SukuWc/FR4-Quad/Render/SensorMix/SensorMix_TOP.png

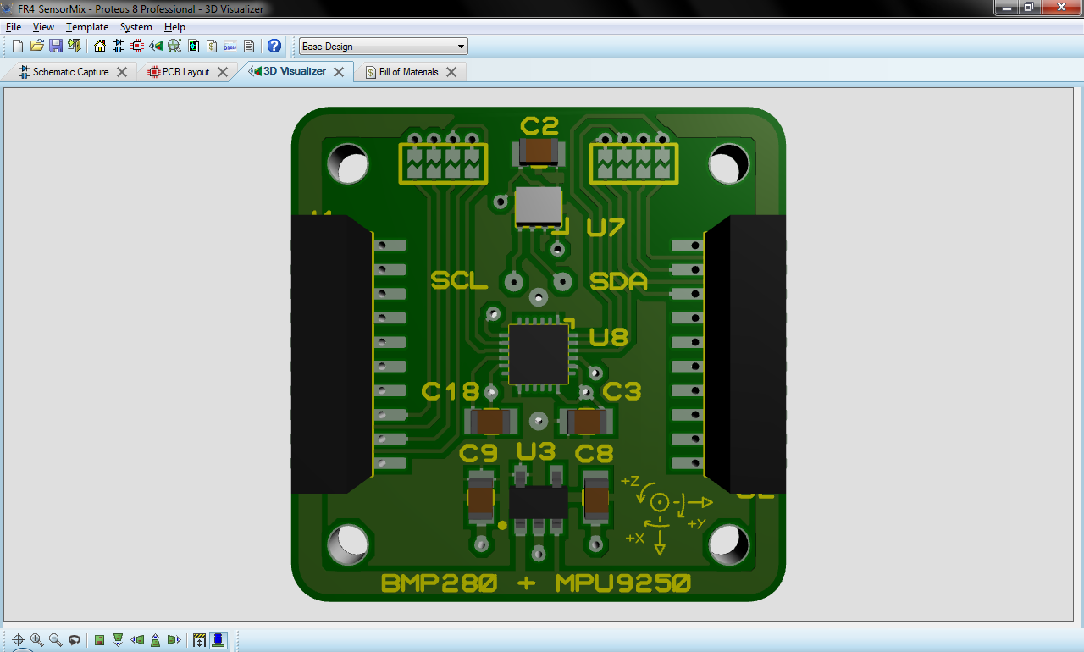
Render/SensorMix/SensorMix_TOP.png
