SukuWc/FR4-Quad/gerber/TOP_COPPER.png

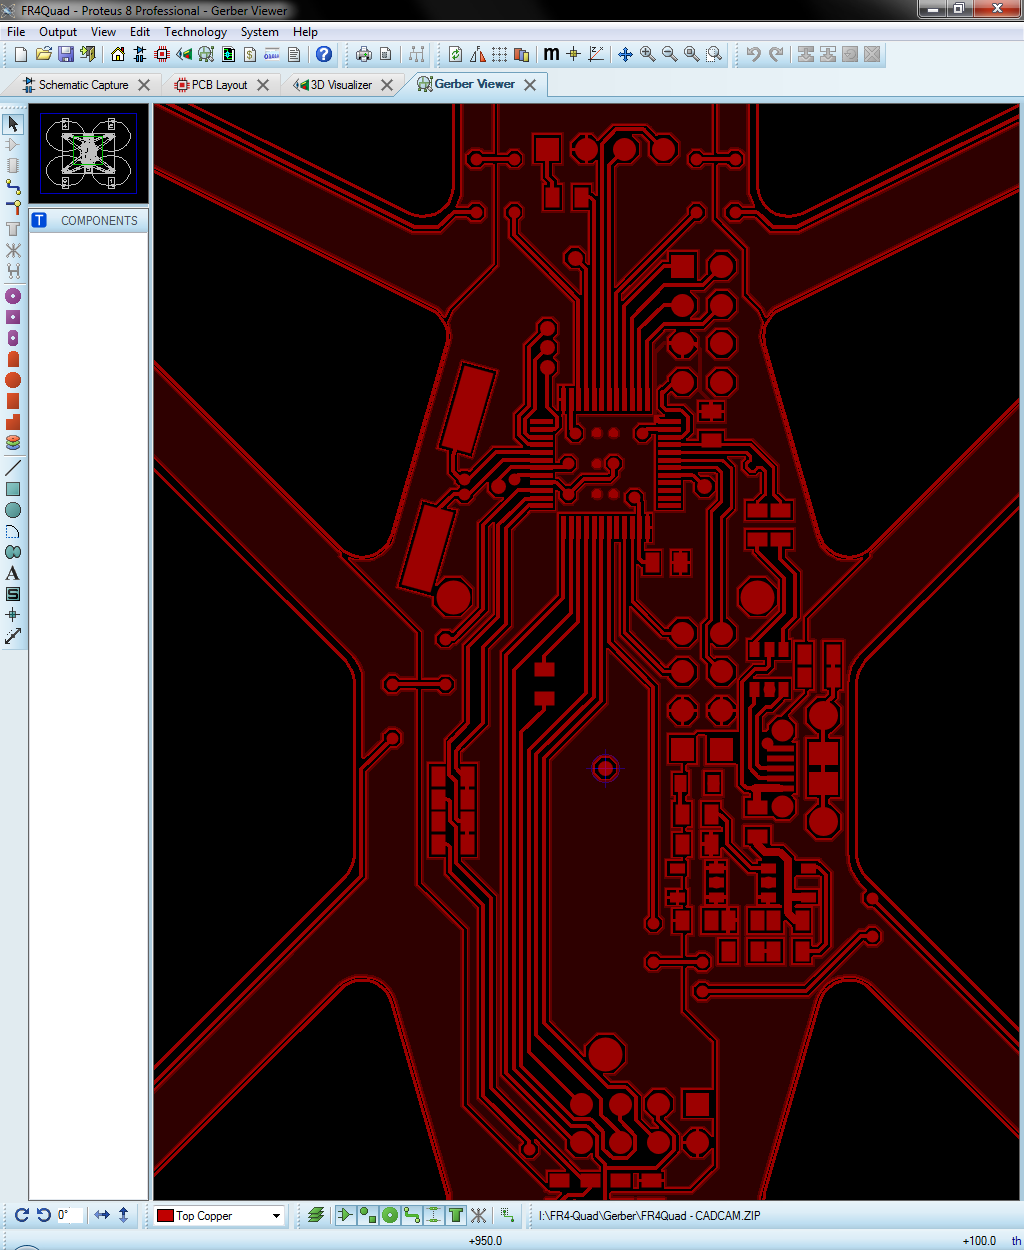
gerber/TOP_COPPER.png
