SukuWc/FR4-Quad/Render/Brain/Brain_BOTTOM.png

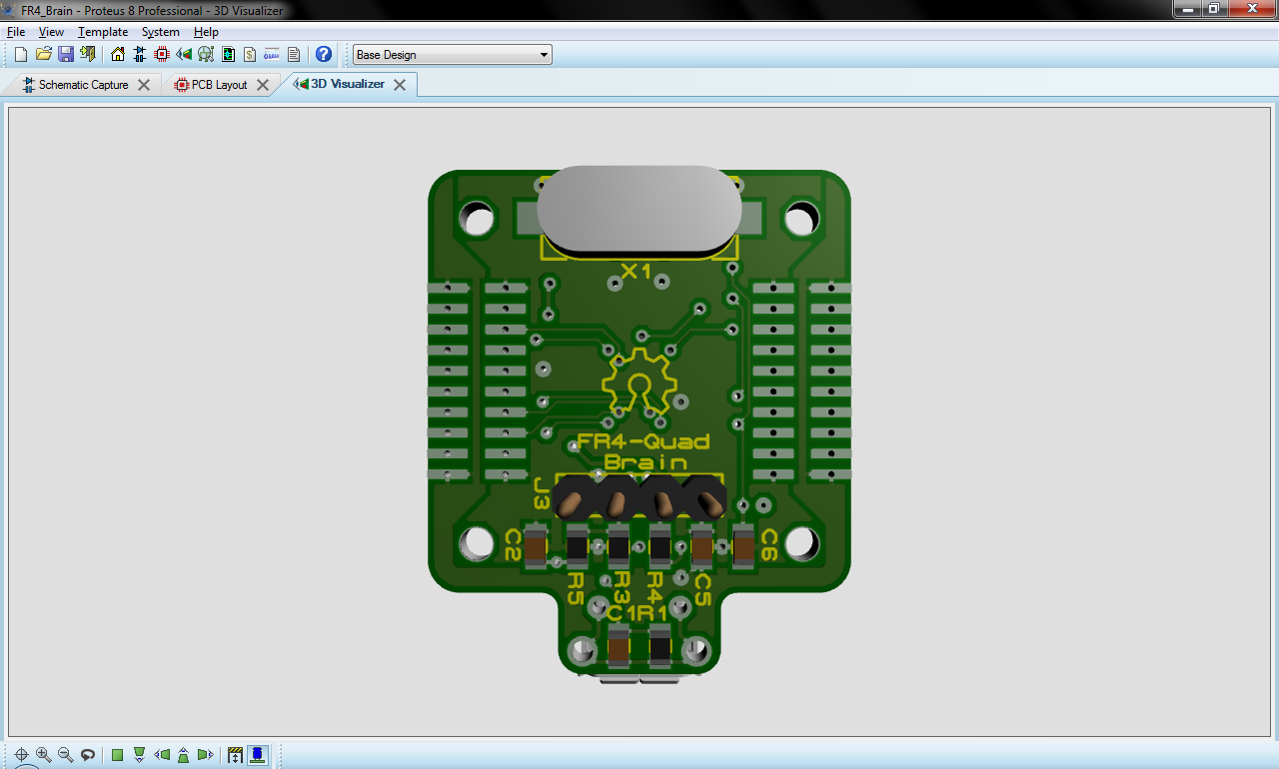
Render/Brain/Brain_BOTTOM.png
