SukuWc/FR4-Quad/Render/Brain/Brain_PCB.png

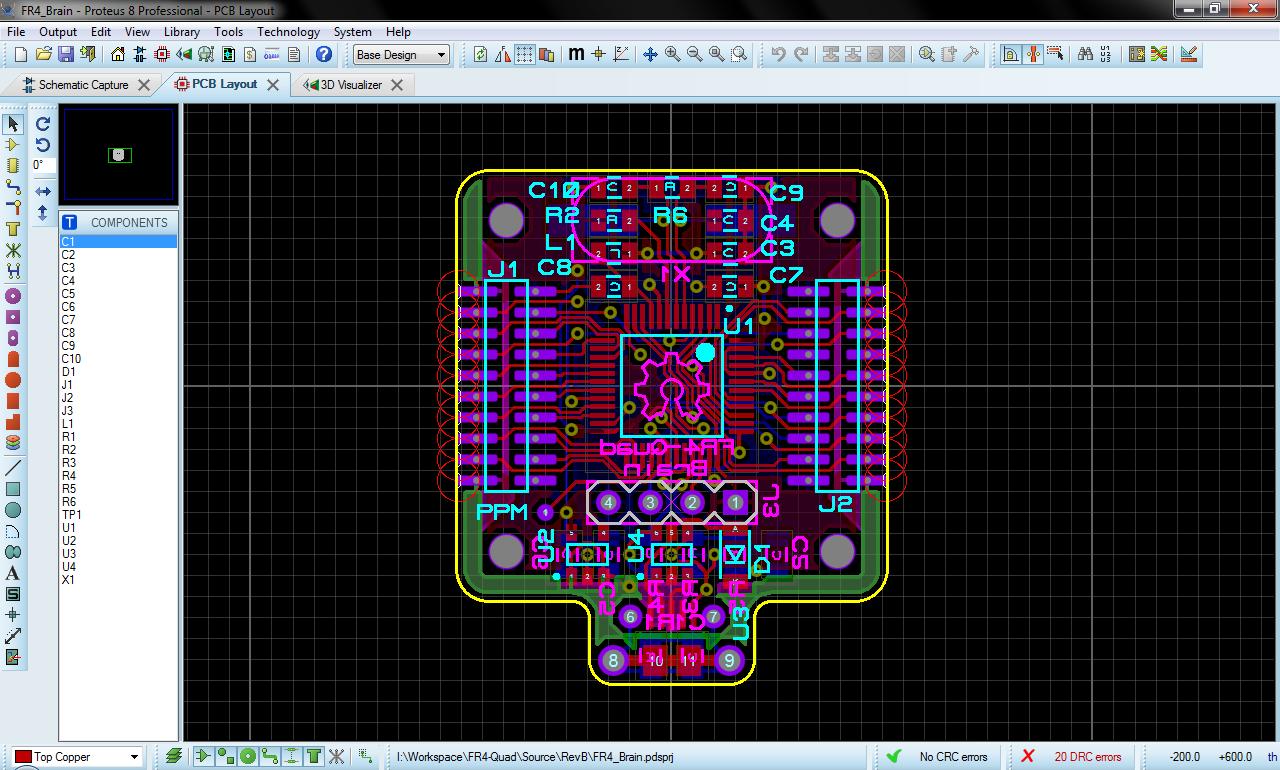
Render/Brain/Brain_PCB.png
