SukuWc/FR4-Quad/Render/Brain/Brain_SCH.png

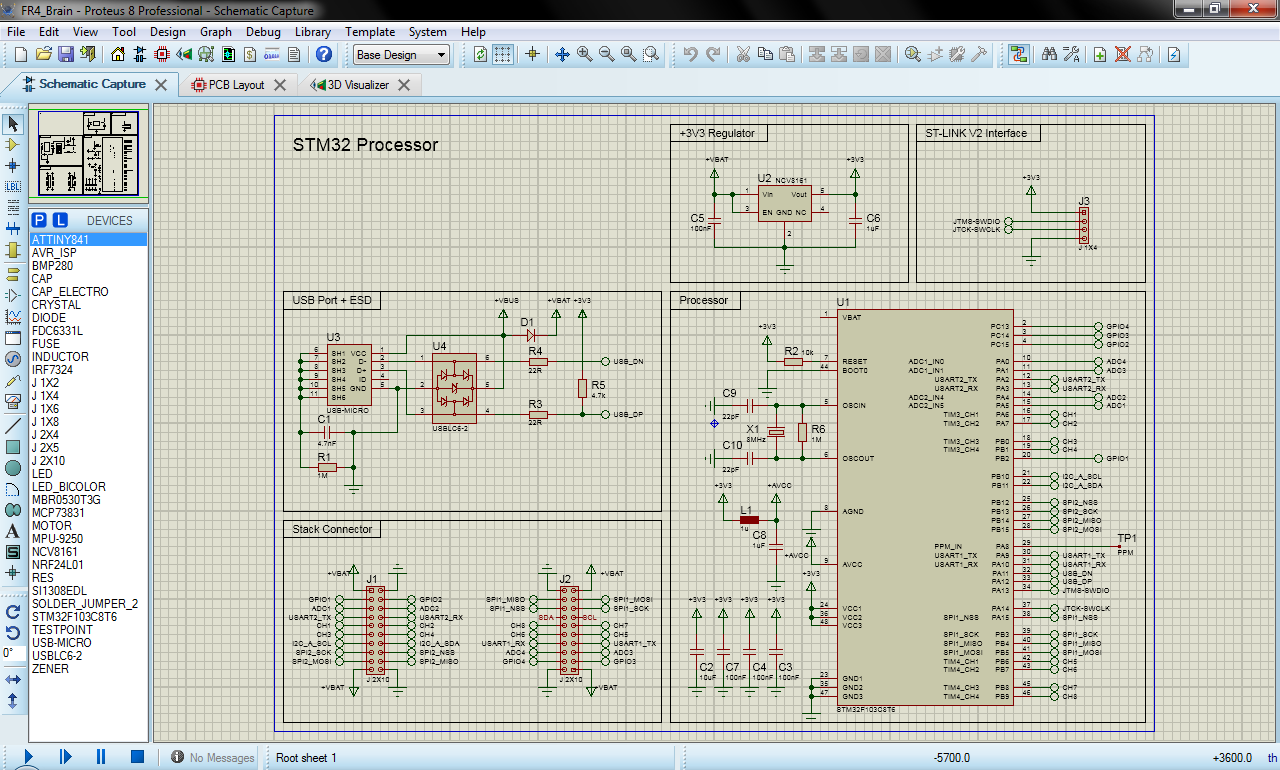
Render/Brain/Brain_SCH.png
