SukuWc/FR4-Quad/Render/Brain/Brain_TOP.png

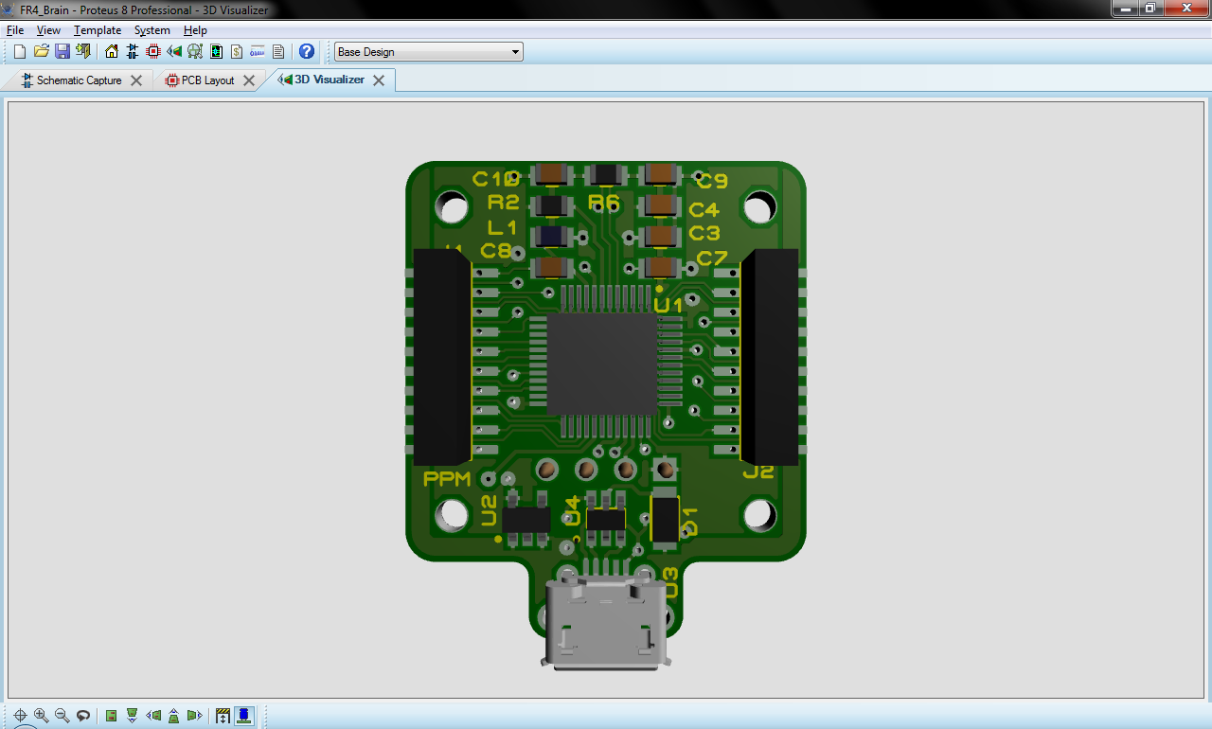
Render/Brain/Brain_TOP.png
