SukuWc/FR4-Quad/Render/Frame/Frame_BOT.png

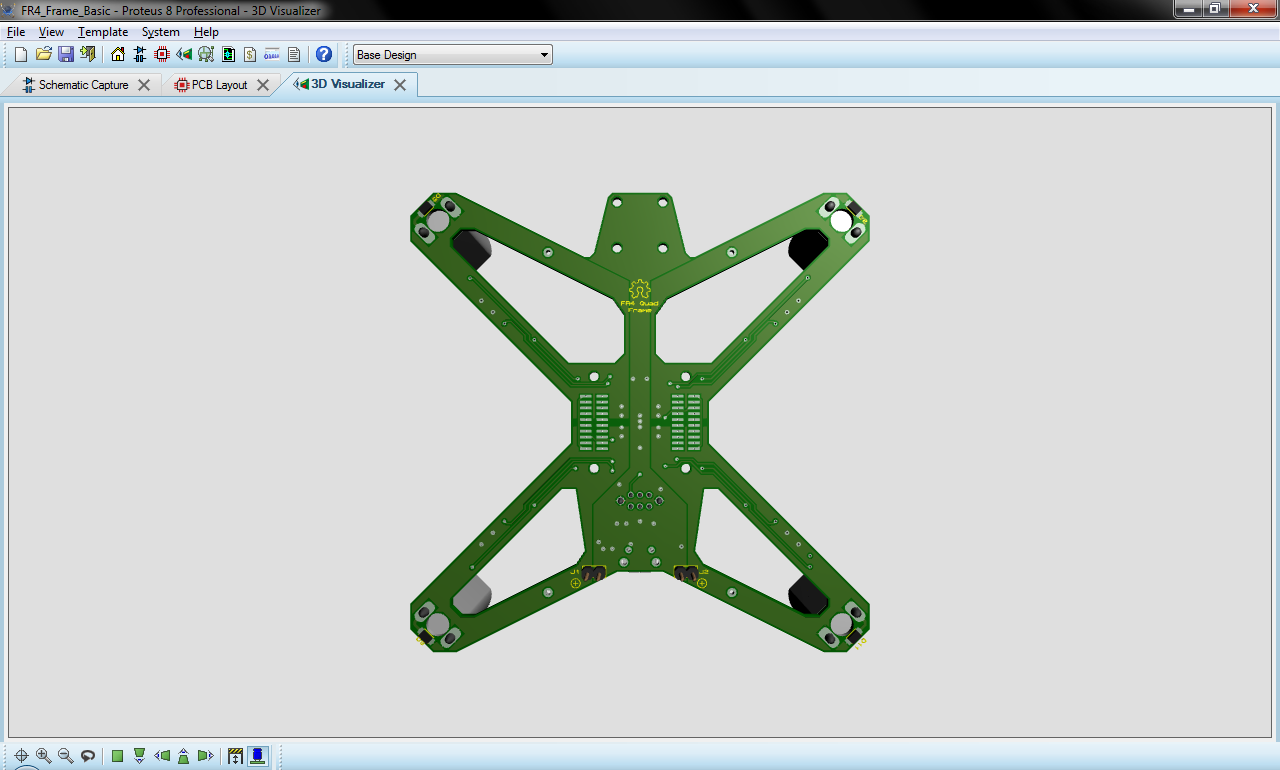
Render/Frame/Frame_BOT.png
