SukuWc/FR4-Quad/Render/Frame/Frame_PCB.png

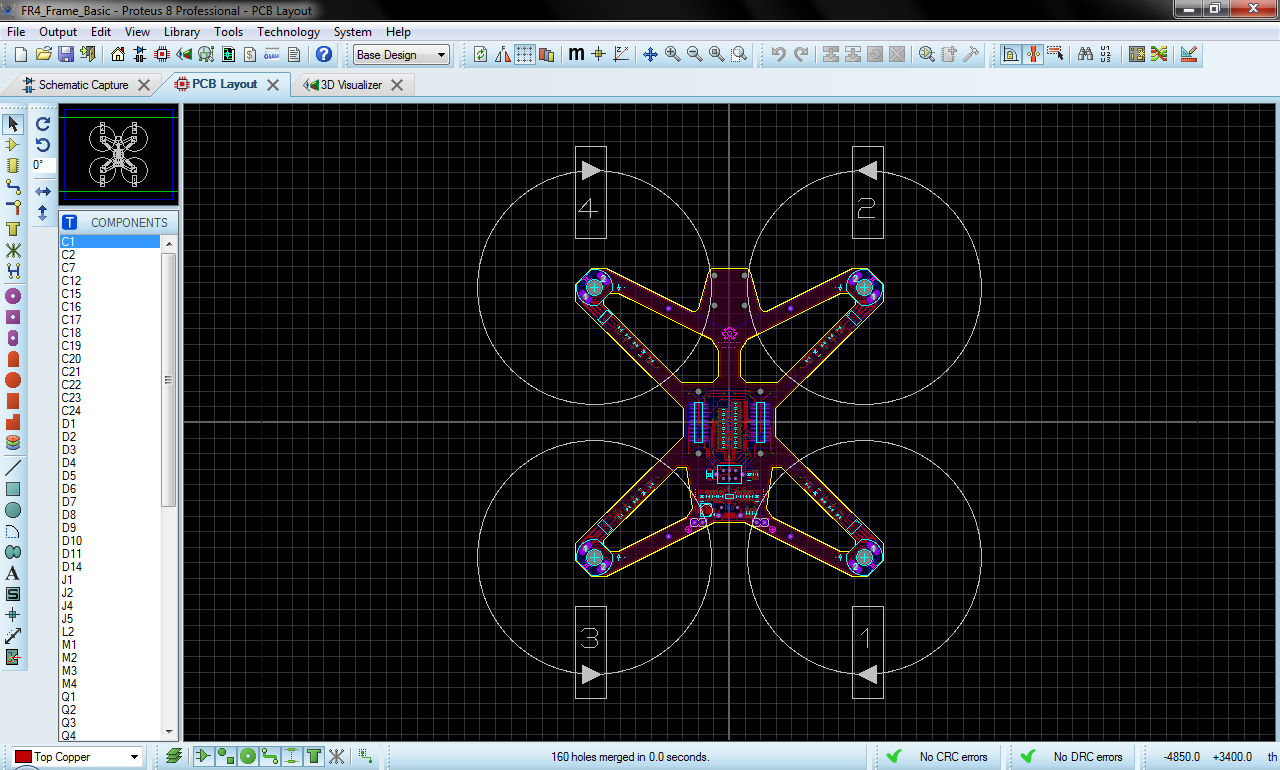
Render/Frame/Frame_PCB.png
