SukuWc/FR4-Quad/Render/Frame/Frame_SCH.png

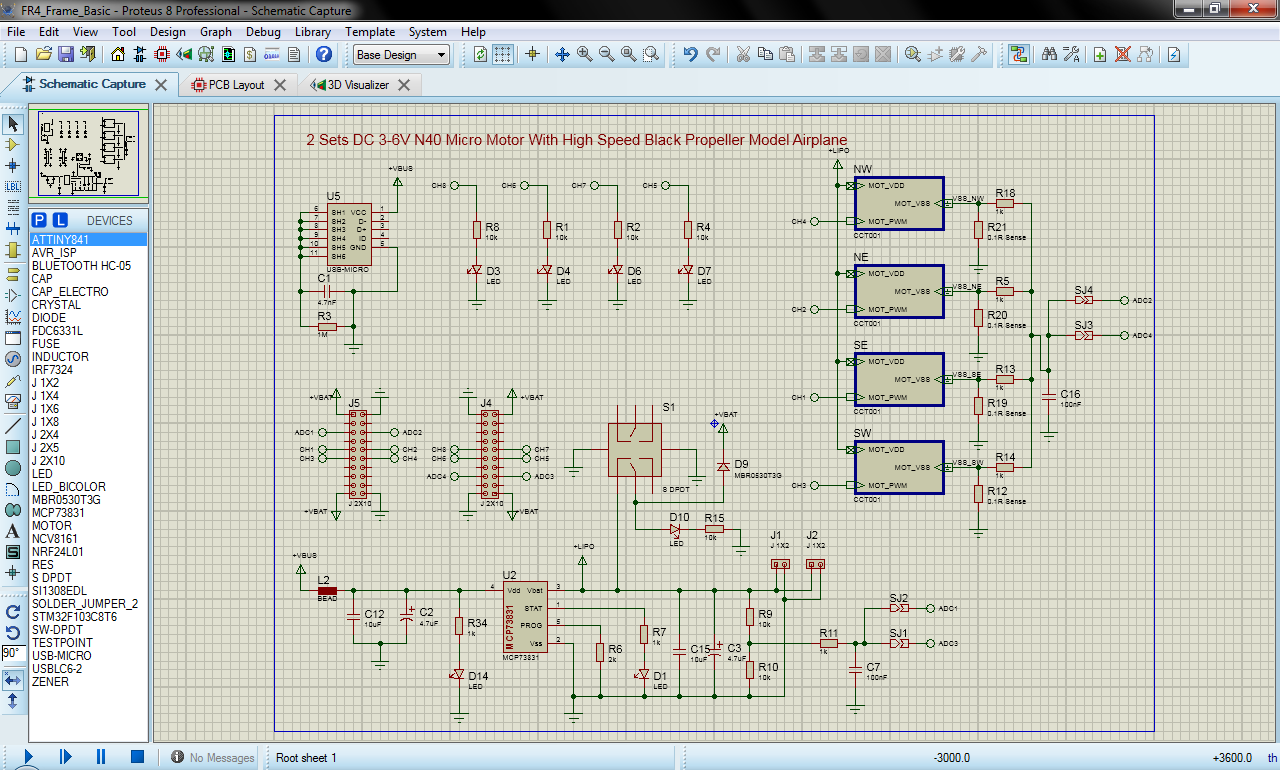
Render/Frame/Frame_SCH.png
