SukuWc/FR4-Quad/Render/Frame/Frame_TOP.png

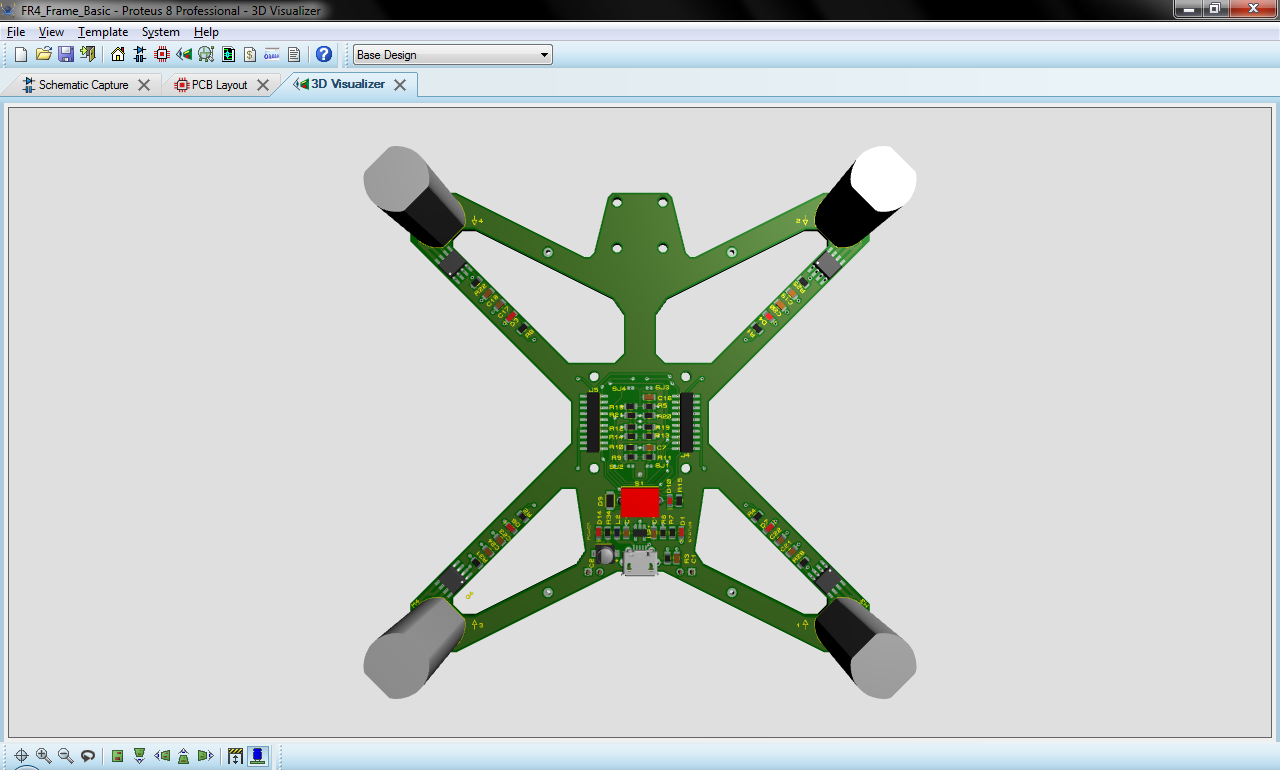
Render/Frame/Frame_TOP.png
