SukuWc/FR4-Quad/Render/Pinout.png

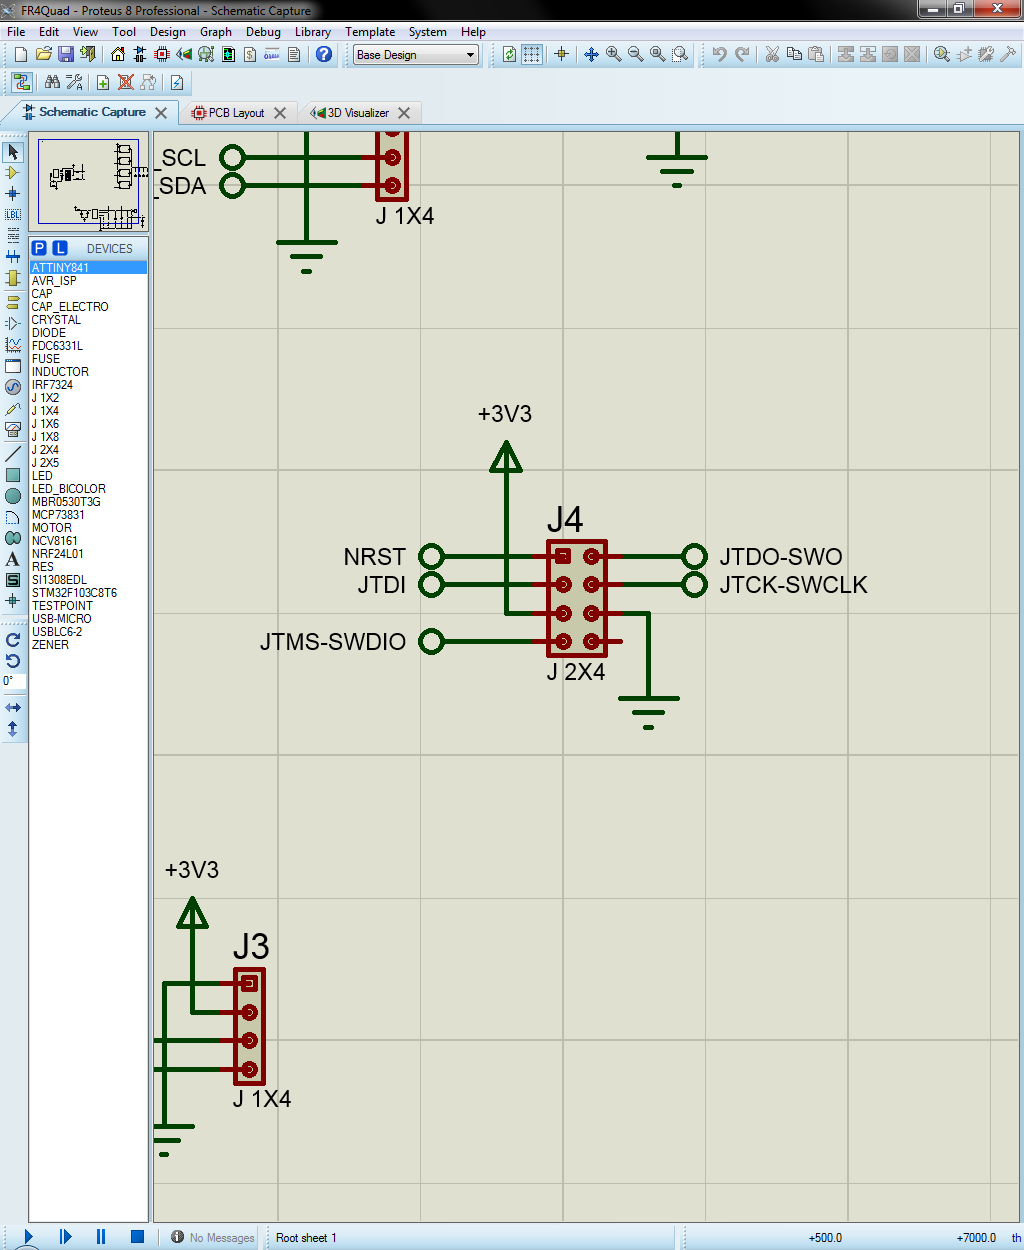
Render/Pinout.png
