SukuWc/FR4-Quad/Render/Render.bmp

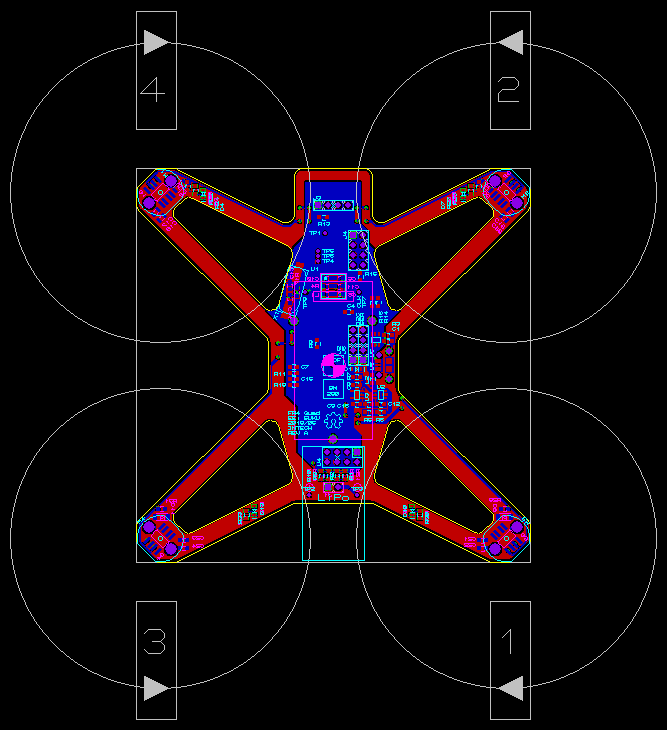
Render/Render.bmp
