SukuWc/FR4-Quad/Render/SensorMix/SensorMix_BOT.png

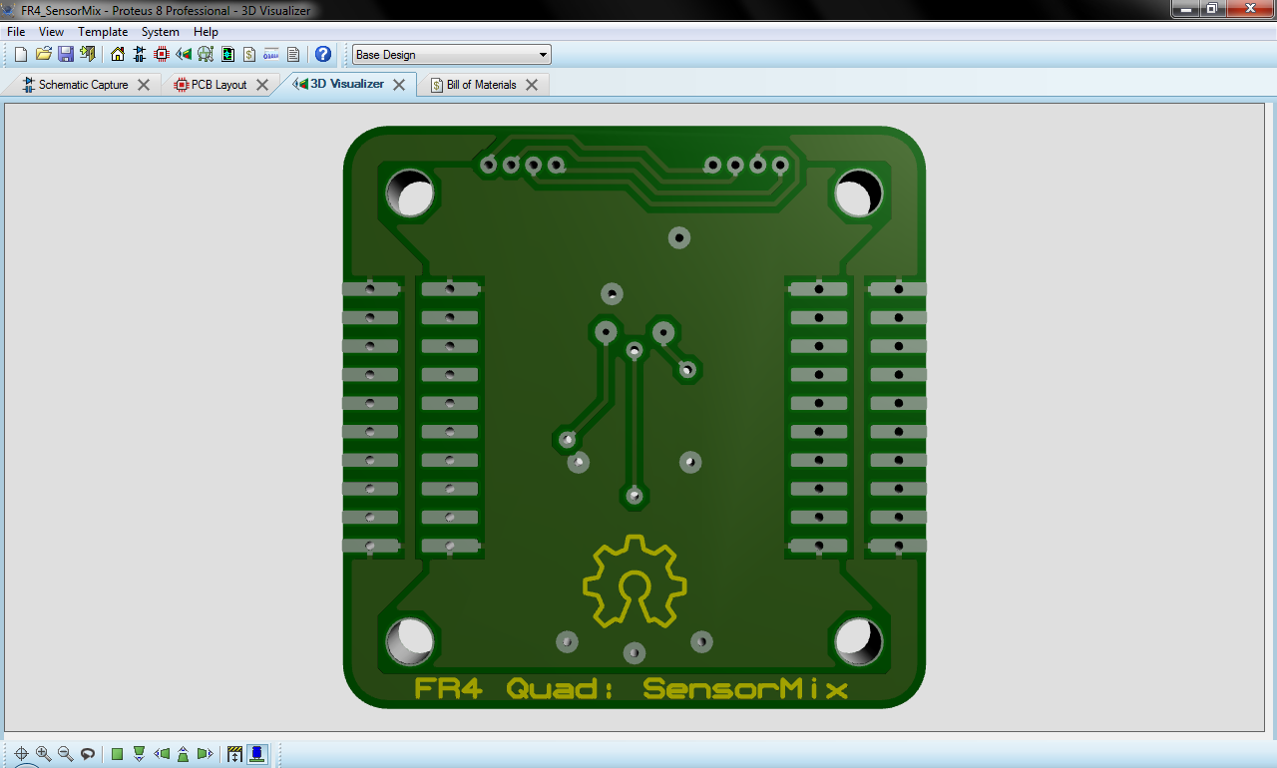
Render/SensorMix/SensorMix_BOT.png
