SukuWc/FR4-Quad/Render/SensorMix/SensorMix_PCB.png

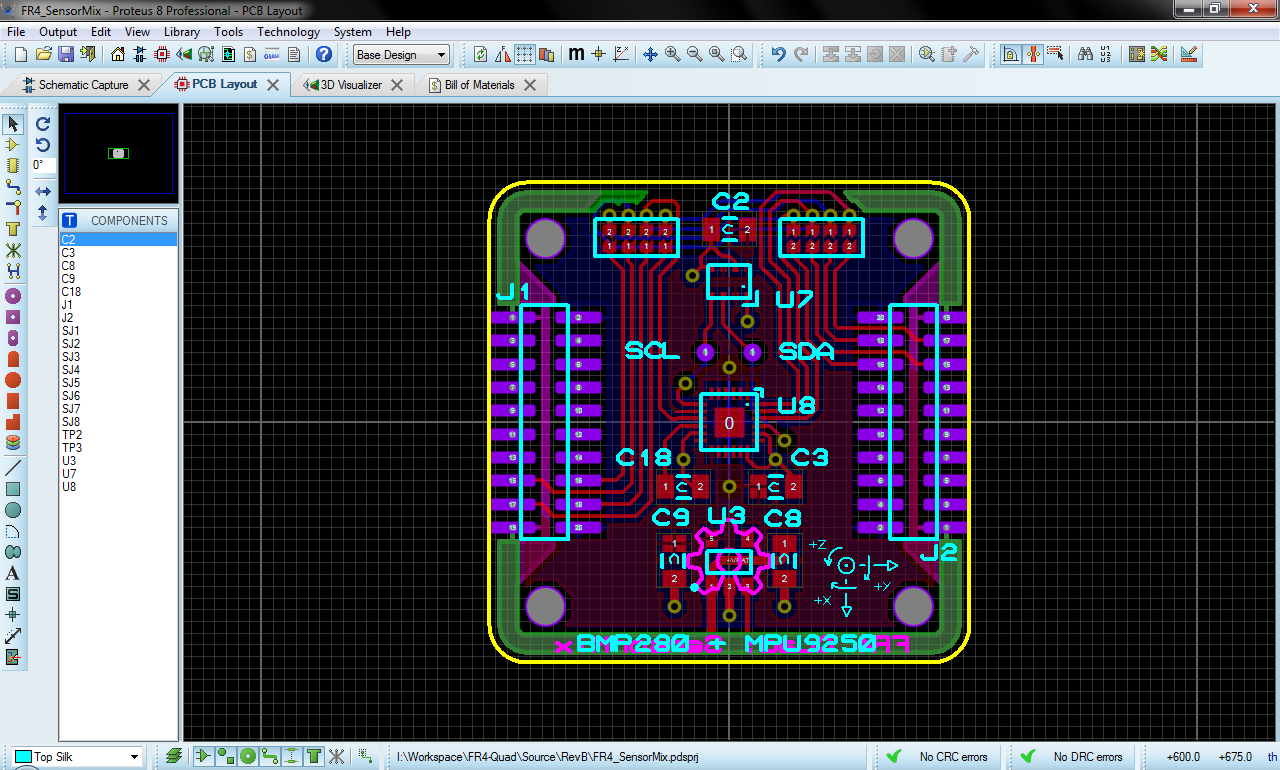
Render/SensorMix/SensorMix_PCB.png
