SukuWc/FR4-Quad/Render/SensorMix/SensorMix_SCH.png

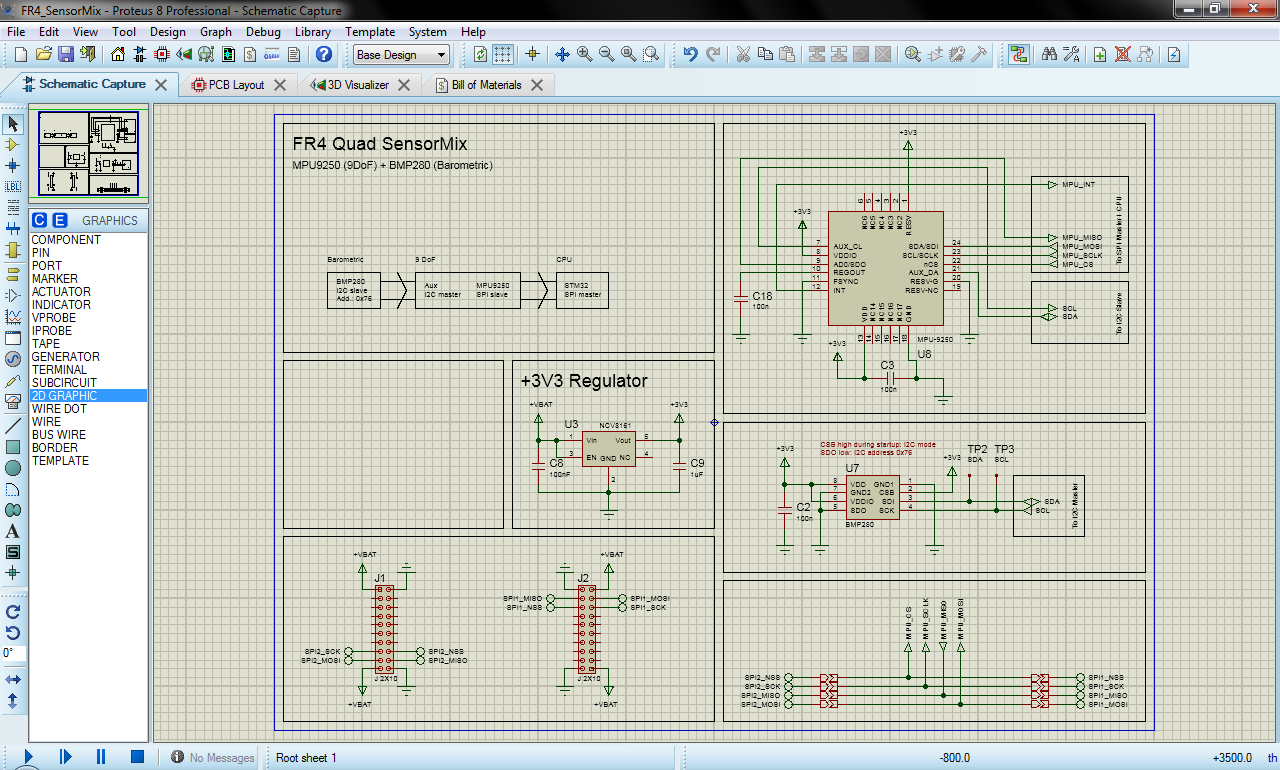
Render/SensorMix/SensorMix_SCH.png
