SukuWc/FR4-Quad/Render/Brain/Brain_BOM.pdf

## Bill Of Materials for FR4_Brain

Design Title | FR4_Brain

### Author Document Number Revision

Design Created | Tuesday, August 07, 2018

### Design Last Modified Sunday, March 17, 2019 Total Parts In Design 27

0 Modules
Quantity | References | Value | Stock Code | Unit Cost
Sub-totals: | | | | $0.00
10 Capacitors
Quantity | References | Value | Stock Code | Unit Cost
1 | C1 | 4.7nF | | $0.02
1 | C2 | 10uF | | $0.02
4 | C3-C5,C7 | 100nF | | $0.02
2 | C6,C8 | 1uF | | $0.02
2 | C9-C10 | 22pF | | $0.02
Sub-totals: | | | | $0.20
6 Resistors
Quantity | References | Value | Stock Code | Unit Cost
2 | R1,R6 | 1M | | $0.02
1 | R2 | 10k | | $0.02
2 | R3-R4 | 22R | | $0.02
1 | R5 | 4.7k | | $0.02
Sub-totals: | | | | $0.12
4 Integrated Circuits
Quantity | References | Value | Stock Code | Unit Cost
1 | U1 | STM32F103C8T6 | | $3.20
1 | U2 | NCV8161 | NCV8161 | $0.20
1 | U3 | USB-MICRO | MX-105017-0001 | $0.50
1 | U4 | USBLC6-2 | USBLC6-2SC6 | $0.15
Sub-totals: | | | | $4.05
0 Transistors
Quantity | References | Value | Stock Code | Unit Cost
Sub-totals: | | | | $0.00
1 Diodes
Quantity | References | Value | Stock Code | Unit Cost
1 | D1 | MBR0530T3G | | $0.05
Sub-totals: | | | | $0.05
6 Miscellaneous
Quantity | References | Value | Stock Code | Unit Cost
2 | J1-J2 | J 2X10 | | $0.25
1 | J3 | J 1X4 | | $0.15
1 | L1 | 1u | | $0.02
1 | TP1 | PPM | | $0.00
1 | X1 | 8MHz | | $0.35
Sub-totals: | | | | $1.02
Totals: | | | | $5.44
| | | | Saturday, May 18, 2019 5:03:07 PM
