SukuWc/FR4-Quad/Render/SensorMix/SensorMix_BOM.pdf

## Bill Of Materials for FR4_SensorMix

Design Title | FR4_SensorMix

### Author Document Number Revision

Design Created | Monday, March 11, 2019

### Design Last Modified Sunday, March 17, 2019 Total Parts In Design 20

0 Modules
Quantity | References | Value | Stock Code | Unit Cost
Sub-totals: | | | | $0.00
5 Capacitors
Quantity | References | Value | Stock Code | Unit Cost
3 | C2-C3,C18 | 100n | | $0.02
1 | C8 | 100nF | | $0.02
1 | C9 | 1uF | | $0.02
Sub-totals: | | | | $0.10
0 Resistors
Quantity | References | Value | Stock Code | Unit Cost
Sub-totals: | | | | $0.00
3 Integrated Circuits
Quantity | References | Value | Stock Code | Unit Cost
1 | U3 | NCV8161 | NCV8161 | $0.20
1 | U7 | BMP280 | BMP280 | $0.75
1 | U8 | MPU-9250 | MPU-9250 | $1.25
Sub-totals: | | | | $2.20
0 Transistors
Quantity | References | Value | Stock Code | Unit Cost
Sub-totals: | | | | $0.00
0 Diodes
Quantity | References | Value | Stock Code | Unit Cost
Sub-totals: | | | | $0.00
12 Miscellaneous
Quantity | References | Value | Stock Code | Unit Cost
2 | J1-J2 | J 2X10 | | $0.25
8 | SJ1-SJ8 | SOLDER_JUMPER_2 | | $0.00
1 | TP2 | SDA | | $0.00
1 | TP3 | SCL | | $0.00
Sub-totals: | | | | $0.50
Totals: | | | | $2.80
| | | | Saturday, May 18, 2019 5:06:29 PM
