SukuWc/FR4-Quad/Mechanical/Import/9032_Joystick.STEP

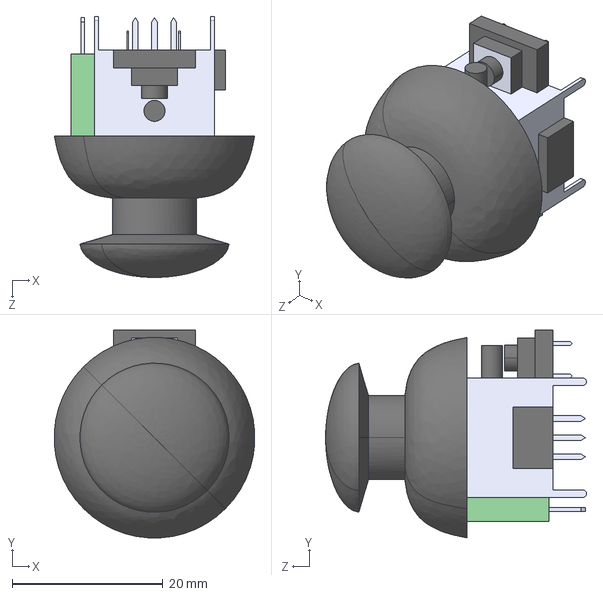
[picture p16: CAD file, 2018-06-05]
Mechanical/Import/9032_Joystick.STEP
26.6 x 27.6 x 34.7 mm
