SukuWc/FR4-Quad/Mechanical/Legs/leg.FCStd

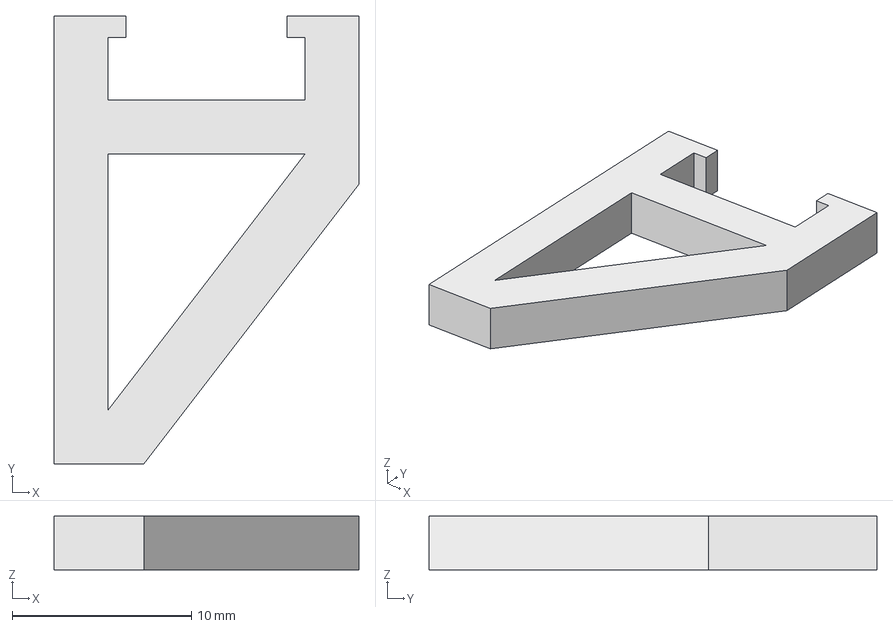
[picture p17: CAD file, 2019-03-04]
Mechanical/Legs/leg.FCStd
17.0 x 25.0 x 3.00 mm
