SukuWc/FR4-Quad/Mechanical/outline.dxf

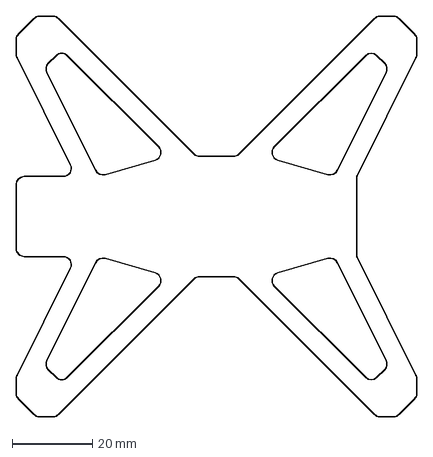
[picture p18: CAD file, 2018-06-05]
Mechanical/outline.dxf
100.0 x 100.0 mm
