SukuWc/FR4-Quad/Render/Brain/FR4_Brain.STEP

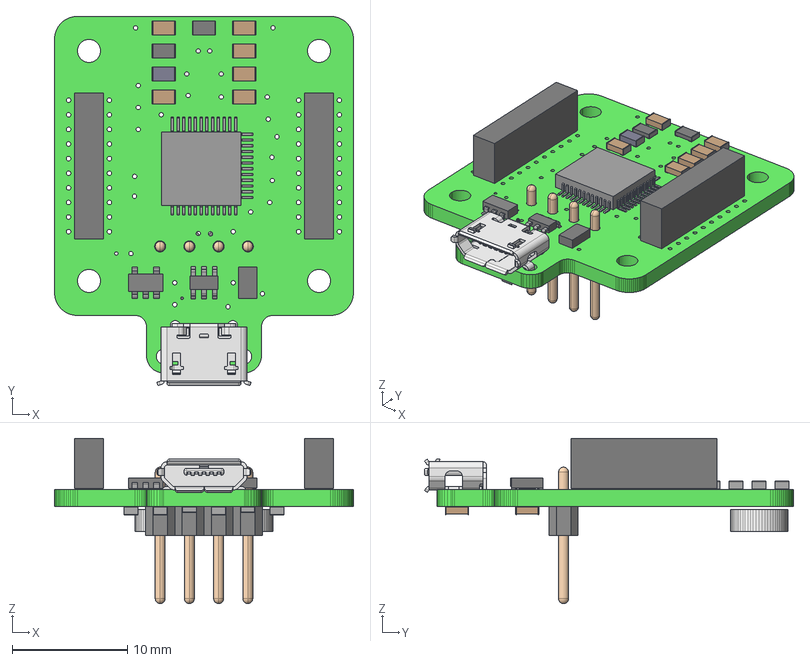
[picture p19: CAD file, 2019-05-18]
Render/Brain/FR4_Brain.STEP
26.0 x 32.1 x 14.4 mm
Layer_1
Pin_1 x 21
Pin_2 x 21
Pin_3 x 4
Pin_4 x 4
Pin_5 x 3
Pin_6 x 2
Pin_7
Pin_8
Pin_9
Pin_10
Pin_11
Pin_12
Pin_13
Pin_14
Pin_15
Pin_16
Pin_17
Pin_18
Pin_19
Pin_20
Pin_21
Pin_22
Pin_23
Pin_24
Pin_25
Pin_26
Pin_27
Pin_28
Pin_29
Pin_30
Pin_31
Pin_32
Pin_33
Pin_34
Pin_35
Pin_36
WIRE x 15
