SukuWc/FR4-Quad/Render/Frame/FR4_Frame_Basic.STEP

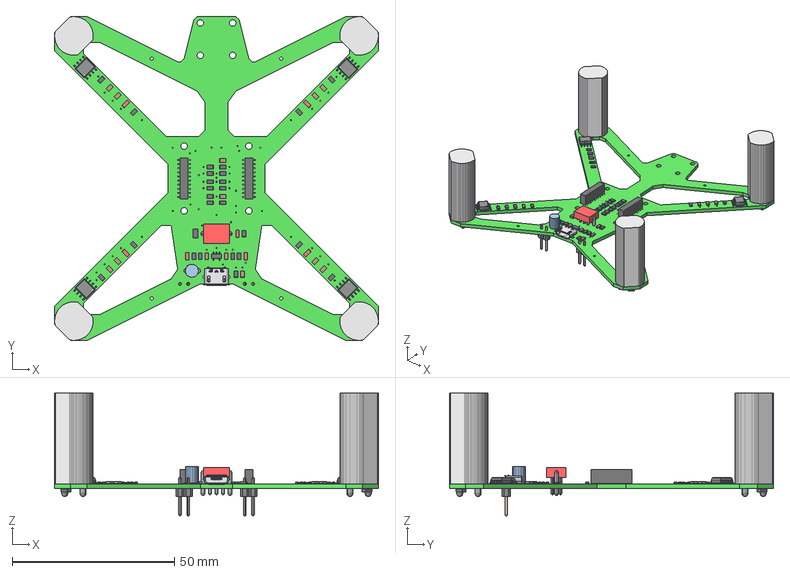
[picture p20: CAD file, 2019-05-18]
Render/Frame/FR4_Frame_Basic.STEP
100.0 x 100.0 x 37.9 mm
Layer_1
Pin_1 x 54
Pin_2 x 54
WIRE x 15
Pin_3 x 2
Pin_4 x 2
Pin_5 x 2
Pin_6
Pin_7
Pin_8
