SukuWc/FR4-Quad/Render/SensorMix/FR4_SensorMix.STEP

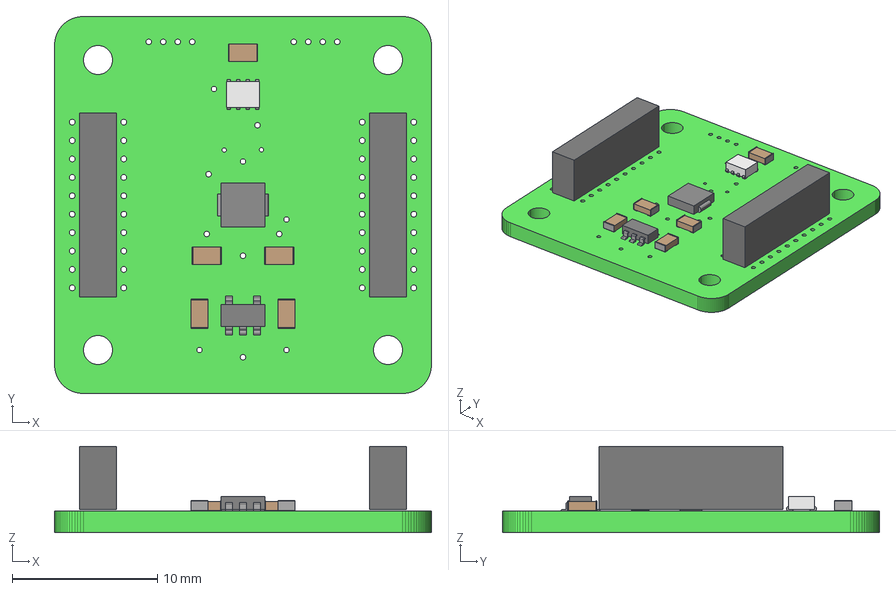
[picture p21: CAD file, 2019-03-18]
Render/SensorMix/FR4_SensorMix.STEP
26.0 x 26.0 x 5.93 mm
Layer_1
Pin_1 x 8
Pin_2 x 7
Pin_3 x 2
Pin_4 x 2
Pin_5 x 2
Pin_6
Pin_7
Pin_8
