SukuWc/FR4-Quad/(list of files, cad)

Other CAD files:
Render/FR4_Brain.STEP
Mechanical/FR4.ipt
Mechanical/Legs/leg.stl
Mechanical/OldVersions/FR4.0002.ipt
