SukuWc/FR4-Quad/Firmware/Arduino-Micro-PPM-Test/RC_Receiver_Timing_Diagram1.jpg

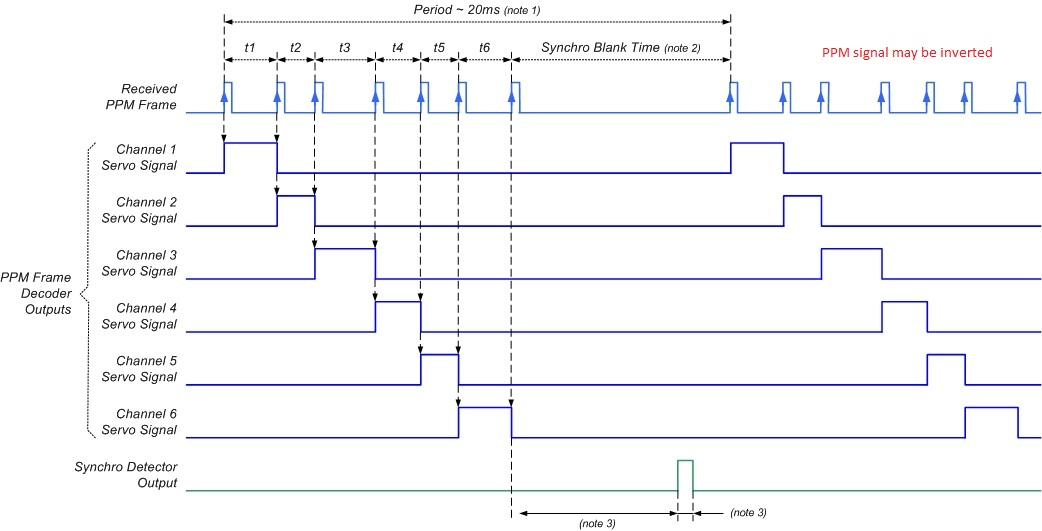
Firmware/Arduino-Micro-PPM-Test/RC_Receiver_Timing_Diagram1.jpg
