SukuWc/FR4-Quad/Render/Schematics.PDF

# Cover Page

# FR4-Quad EE: Suku 2019/1 RevB

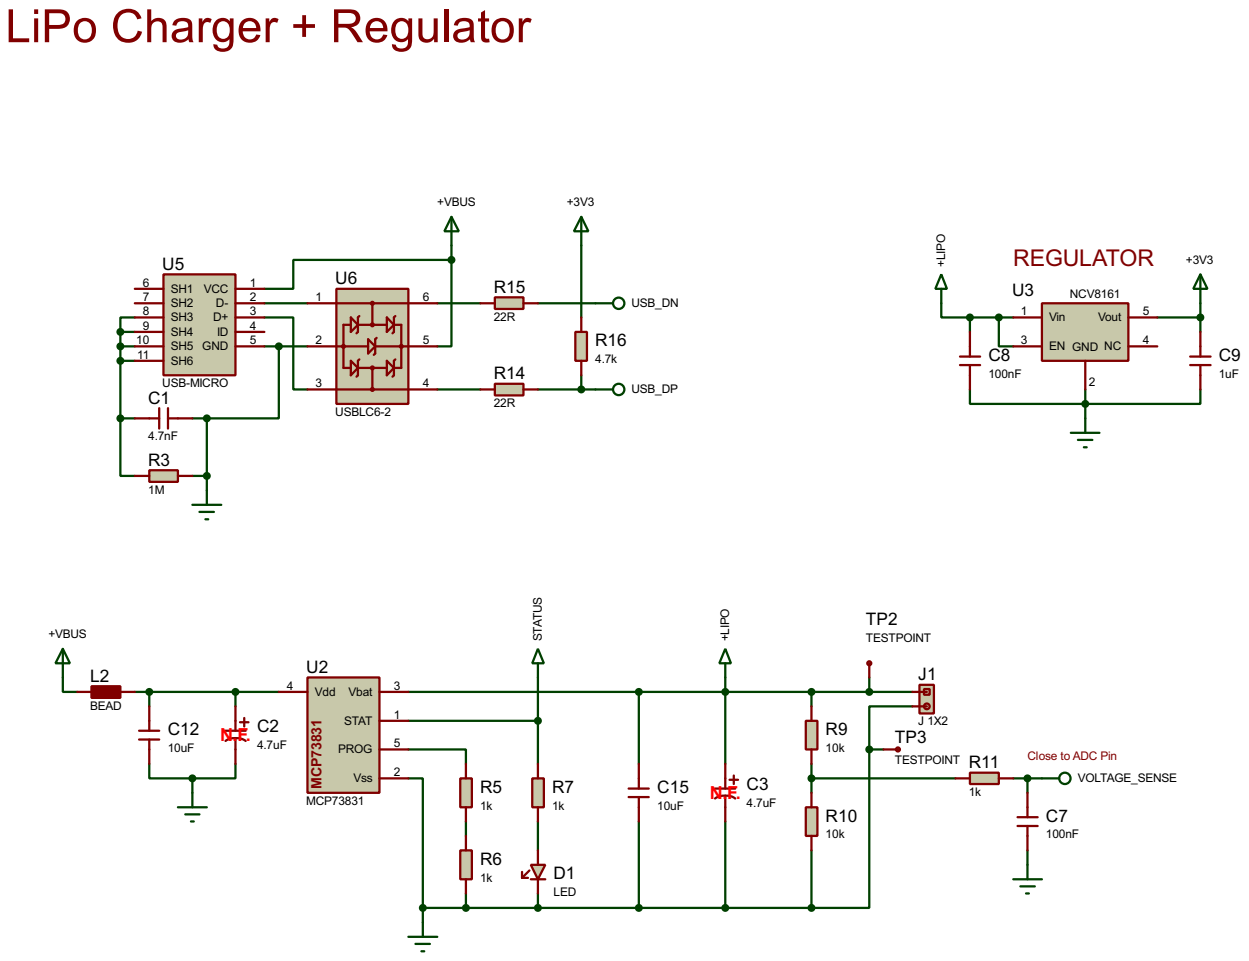
[picture p24: page 2]

VOLTAGE_SENSE Close to ADC Pin R11

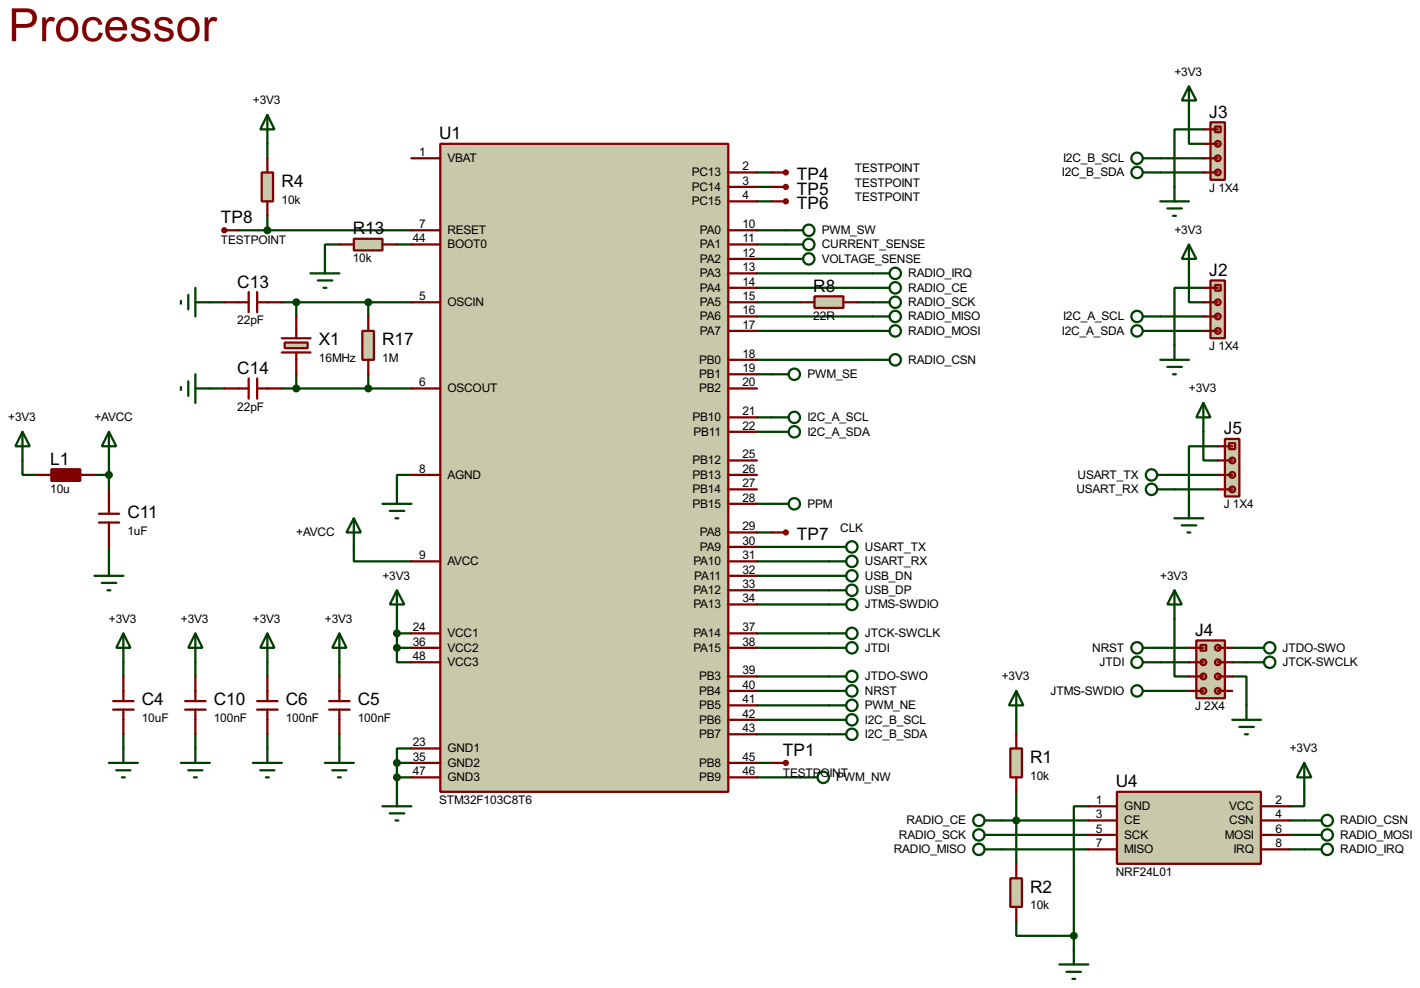
[picture p25: page 3]

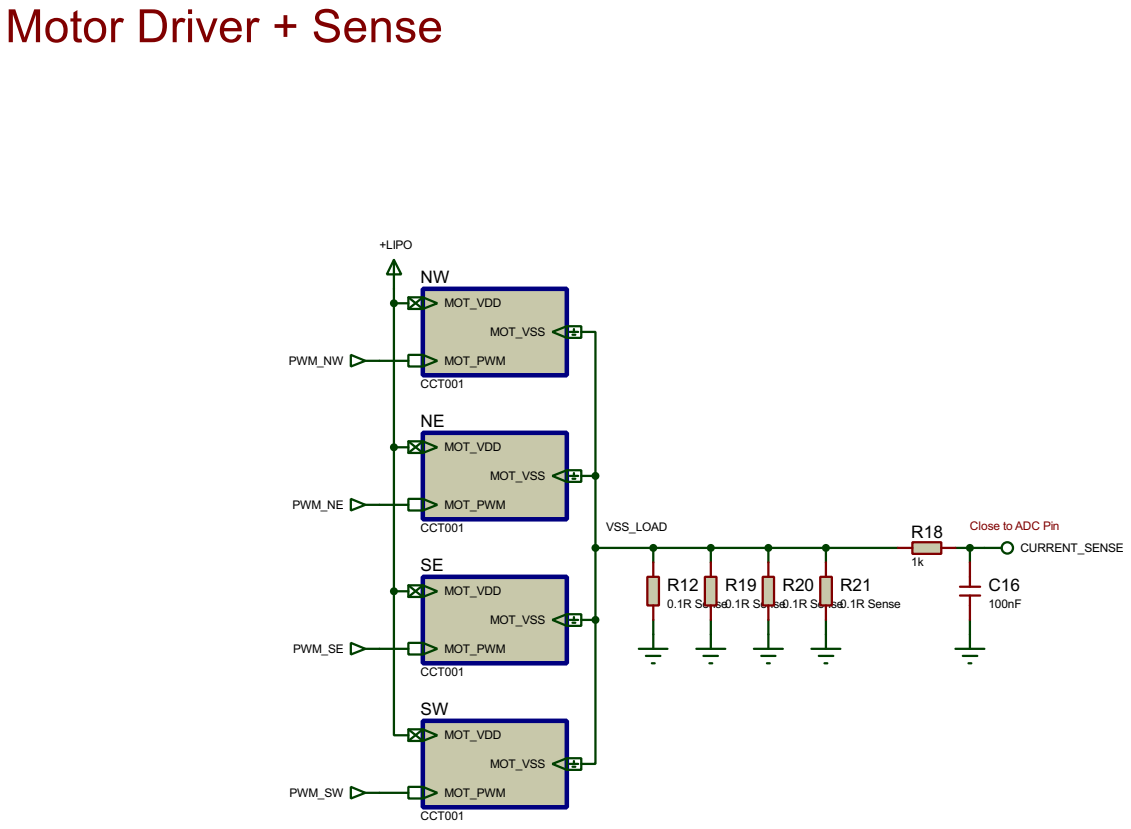
[picture p26: page 4]

CURRENT_SENSE Close to ADC Pin R18

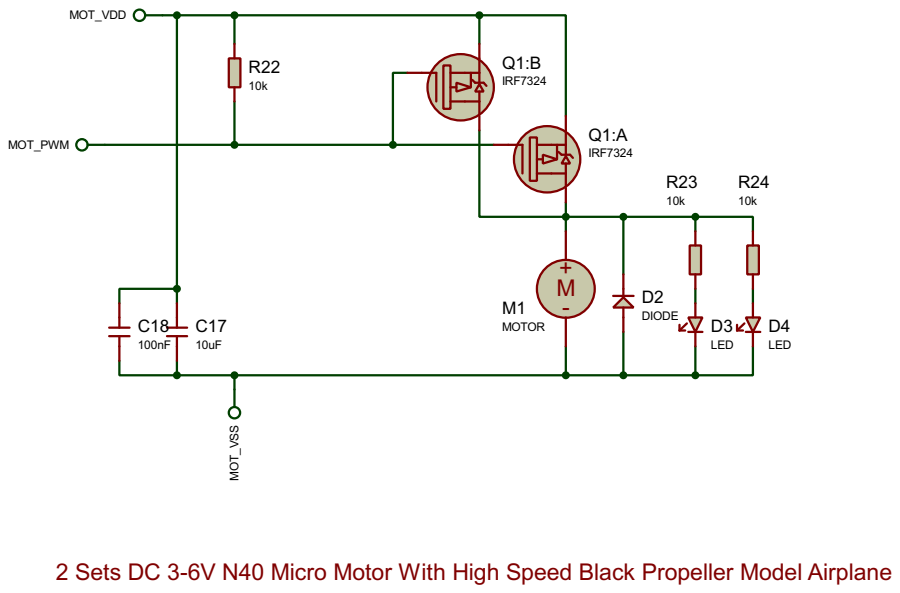
[picture p27: page 5]

2 Sets DC 3-6V N40 Micro Motor With High Speed Black Propeller Model Airplane

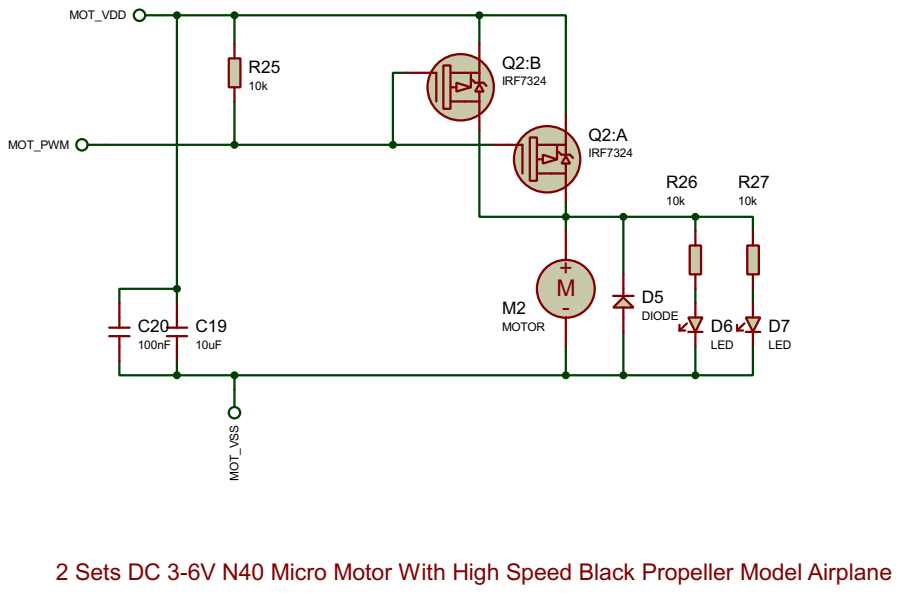
[picture p28: page 6]

2 Sets DC 3-6V N40 Micro Motor With High Speed Black Propeller Model Airplane

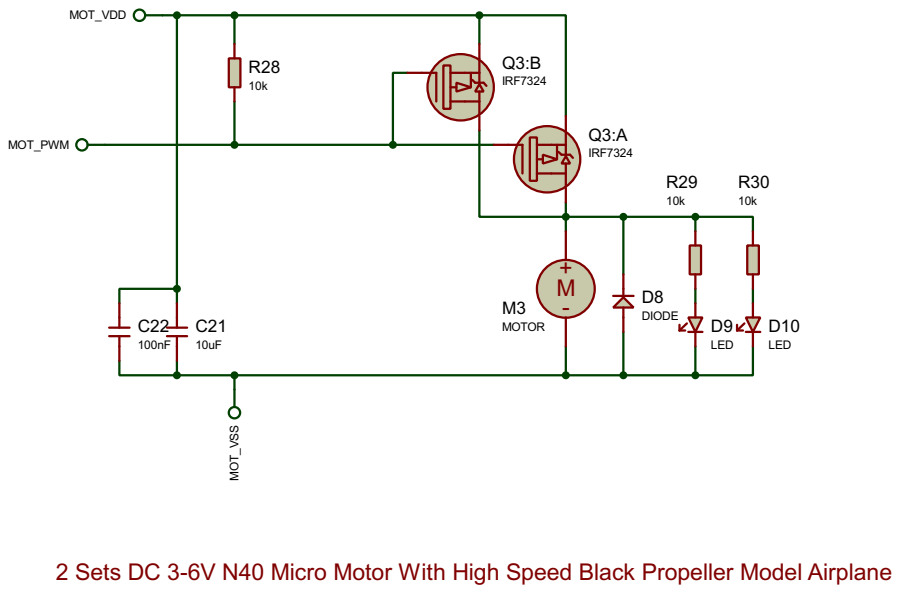
[picture p29: page 7]

2 Sets DC 3-6V N40 Micro Motor With High Speed Black Propeller Model Airplane

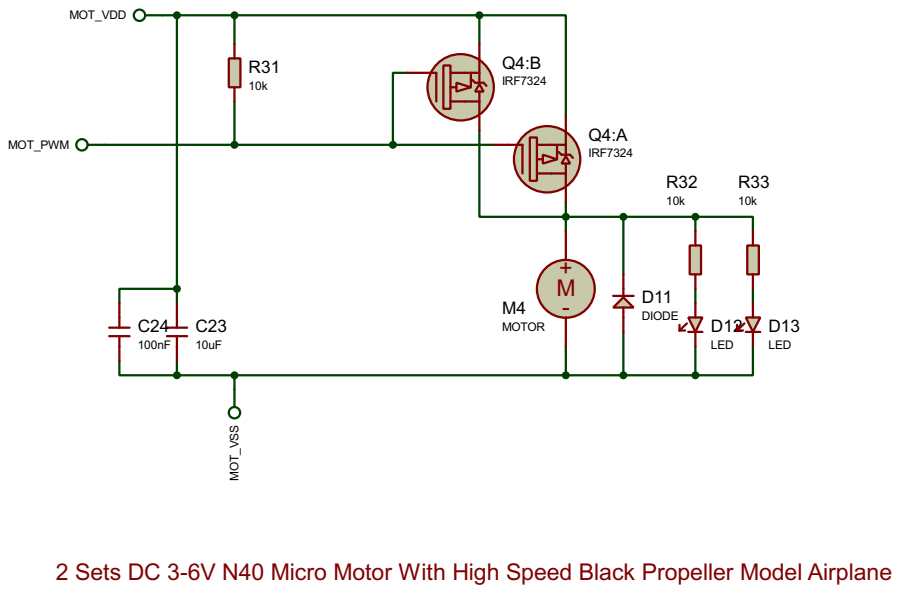
[picture p30: page 8]

2 Sets DC 3-6V N40 Micro Motor With High Speed Black Propeller Model Airplane
