SukuWc/FR4-Quad/Render/SensorMix/SensorMix_SCH.PDF

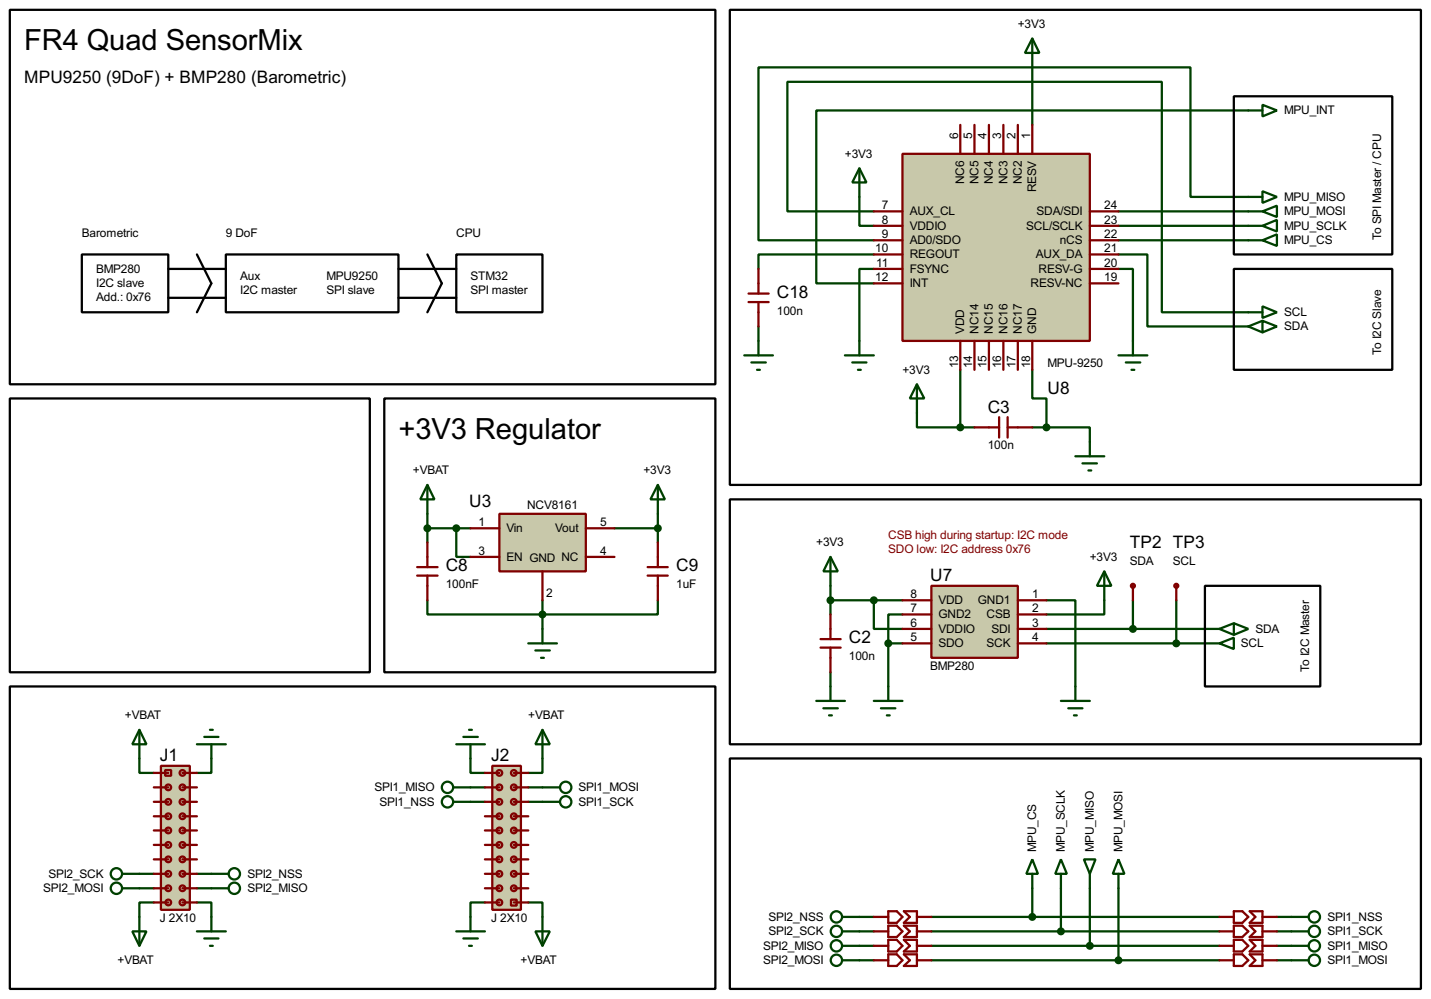
[picture p31: page 1]

To SPI Master / CPU To I2C Slave

+3V3 CSB high during startup: I2C mode SDO low: I2C address 0x76
