SukuWc/FR4-Quad/Render/PCB.PDF

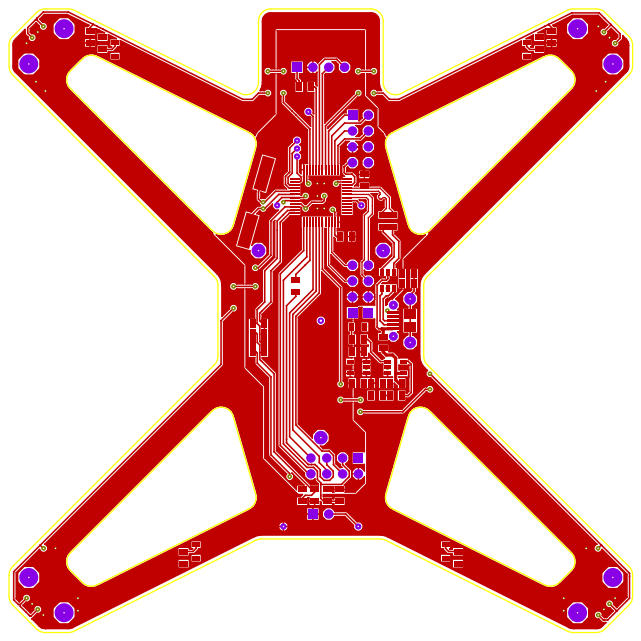
[picture p32: page 1]

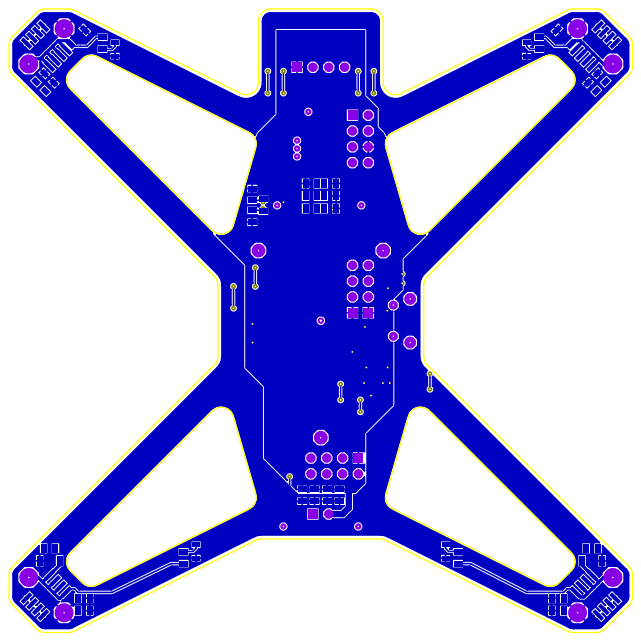
[picture p33: page 2]

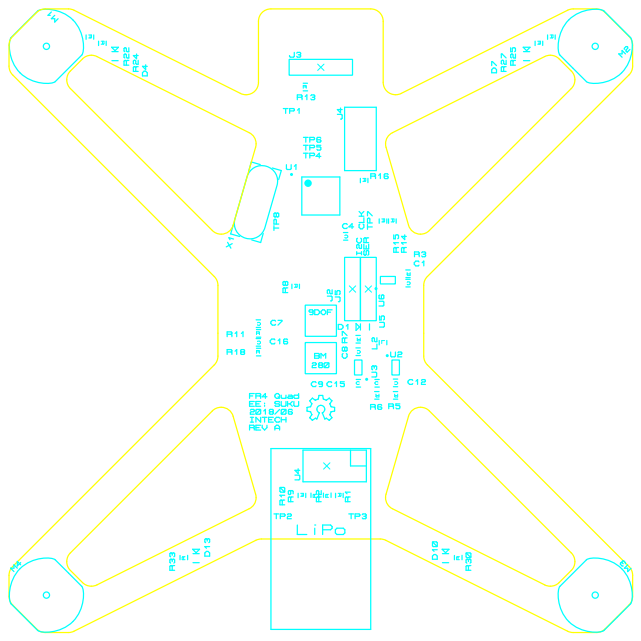
[picture p34: page 3]

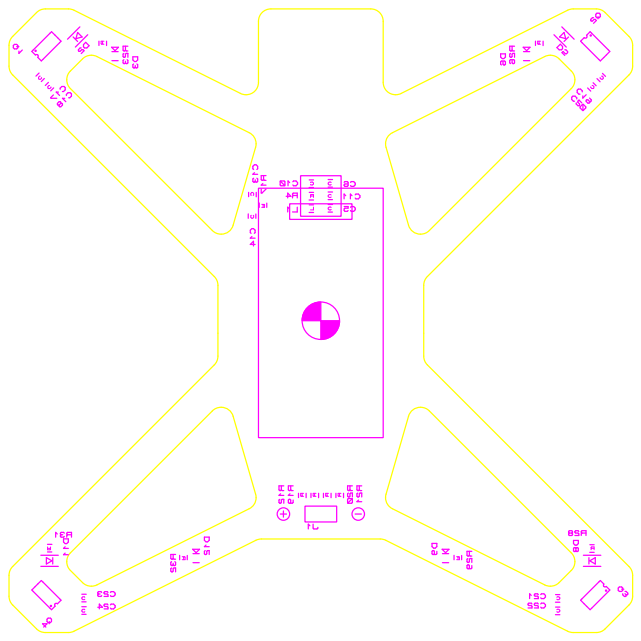
[picture p35: page 4]

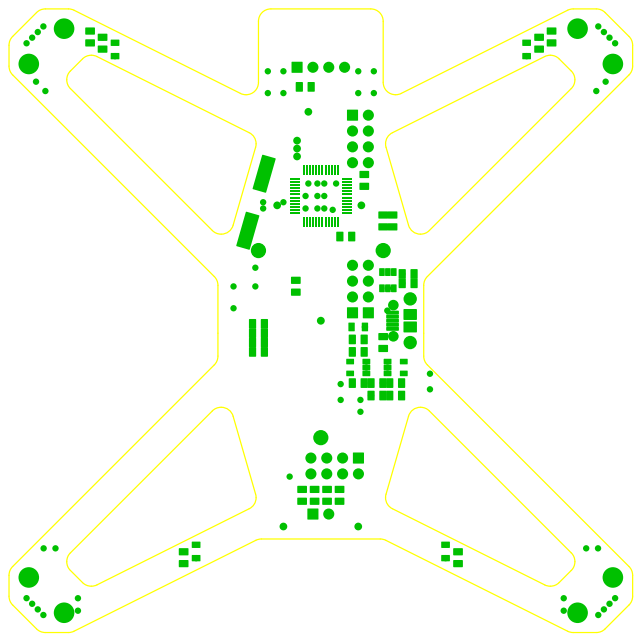
[picture p36: page 5]

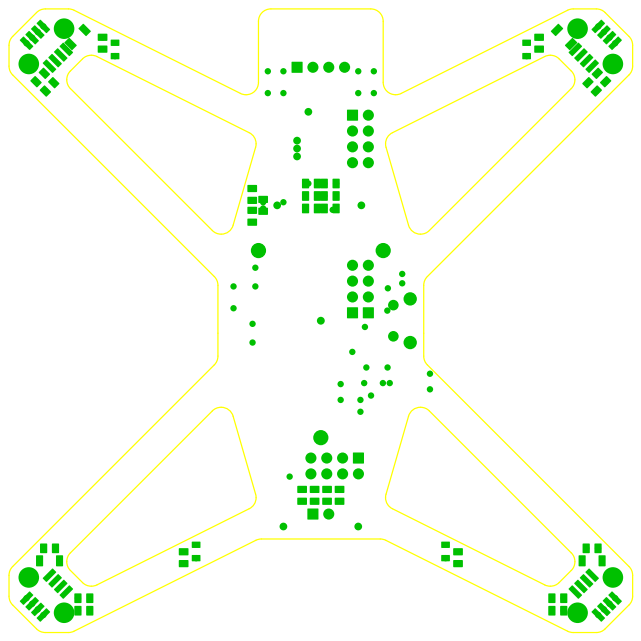
[picture p37: page 6]

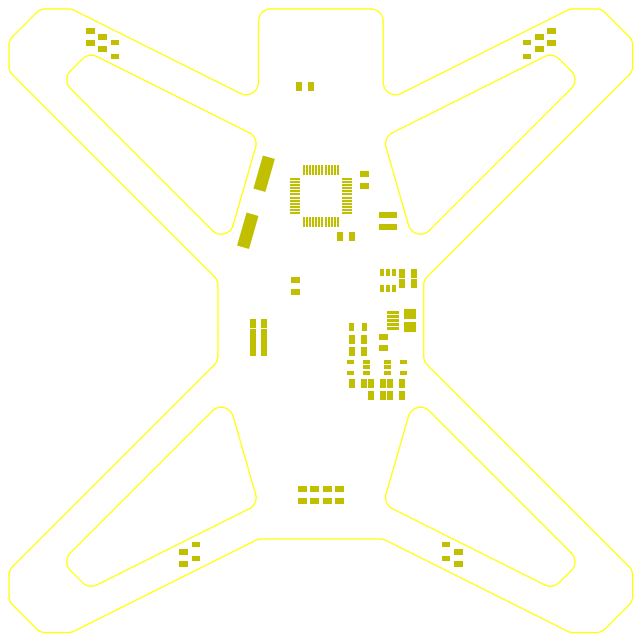
[picture p38: page 7]

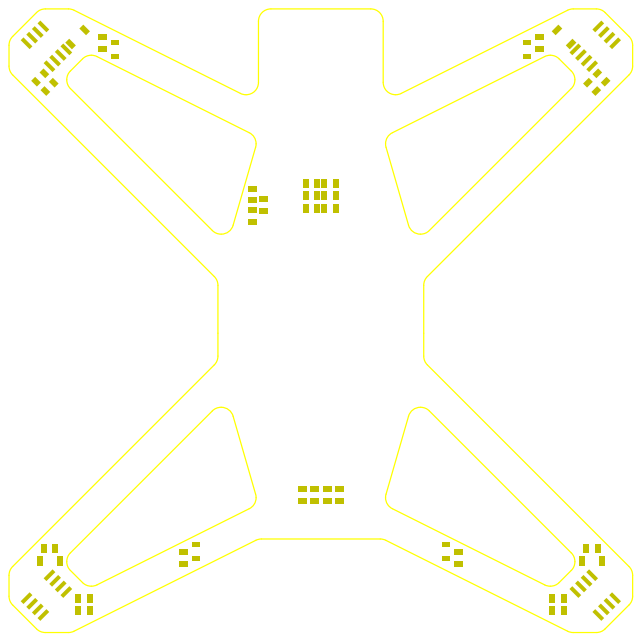
[picture p39: page 8]

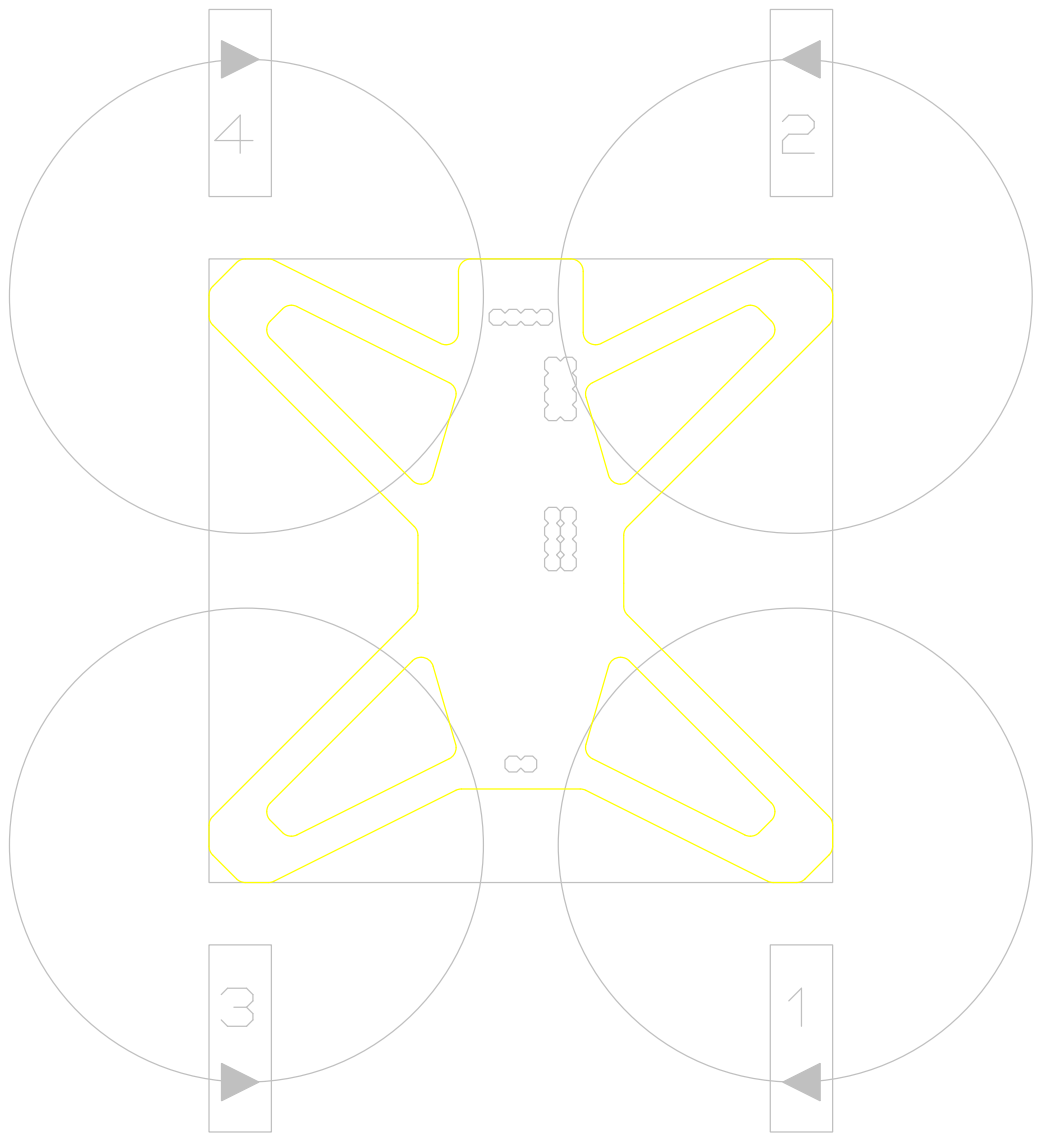
[picture p40: page 9]
