SukuWc/FR4-Quad/Render/Brain/Brain_SCH.PDF

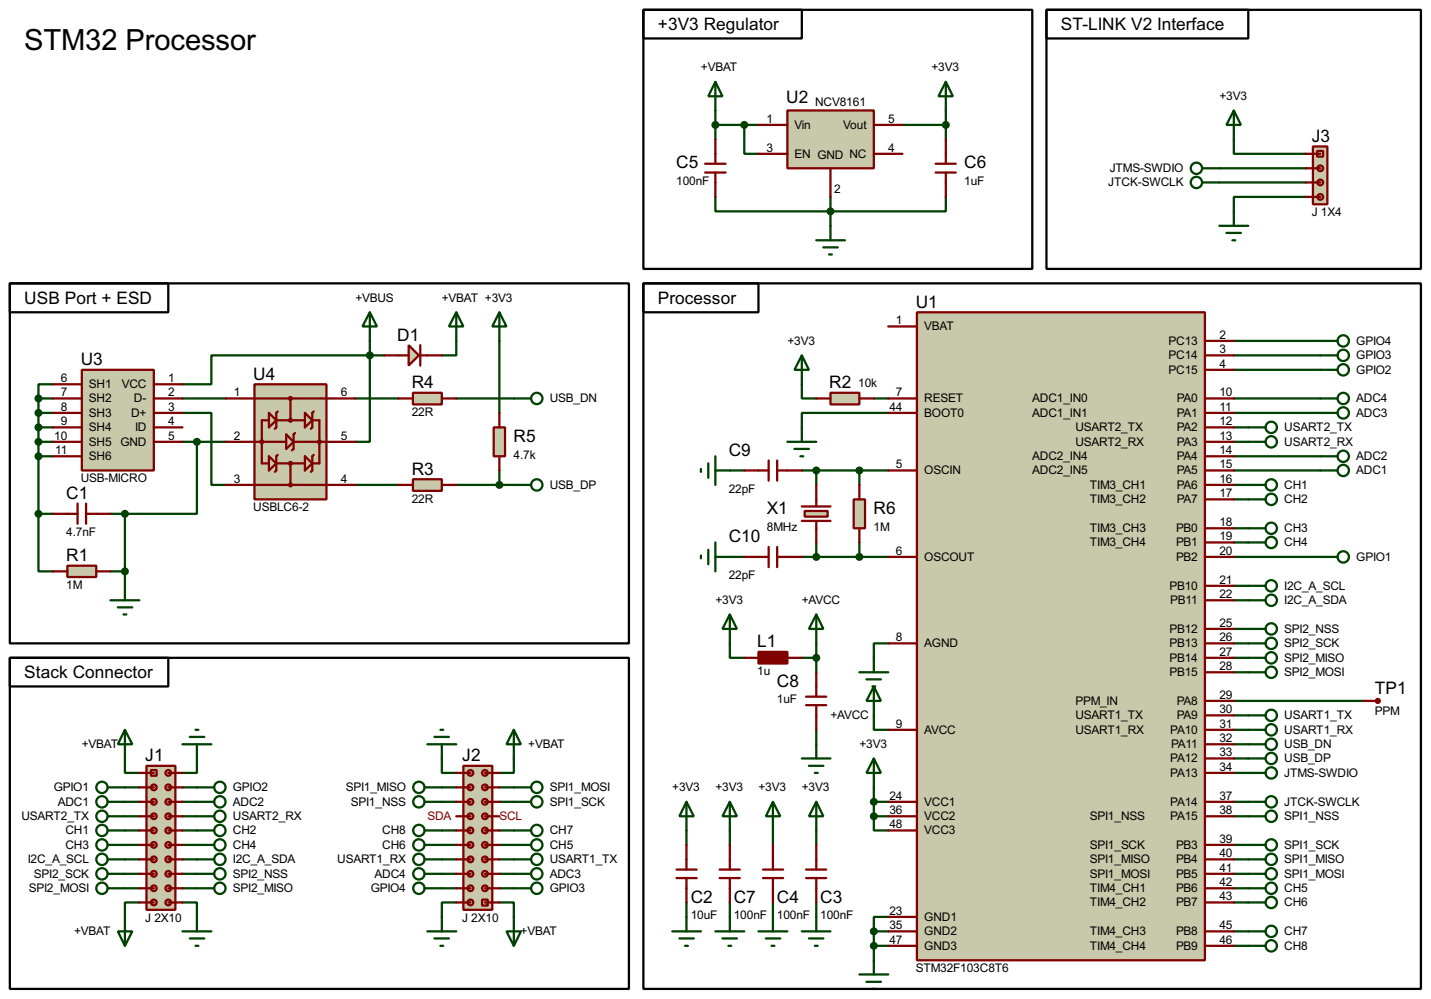
[picture p41: page 1]
