SukuWc/FR4-Quad/(list of files, drawings)

Other design files:
Source/FR4Quad.pdsprj
Source/FR4Radio.pdsprj
Source/RevB/FR4_Bluetooth_HC-05.pdsprj
Source/RevB/FR4_Brain.pdsprj
Source/RevB/FR4_Frame_Basic.pdsprj
Source/RevB/FR4_Proto.pdsprj
Source/RevB/FR4_SensorMix.pdsprj
