SukuWc/FR4-Quad/Matlab/params.txt

m = 80g


//3x9cm 40g közép
3e-06
2.7e-05
3e-05

//10g motor
2.025e-05
2.809e-05
3.969e-05

eredo
8.4e-05
1.393e-04
1.887e-04
