SukuWc/FR4-Quad/Firmware/quad_revb/Inc/bsp/mpu9250.h

#ifndef __mpu9250_H
#define __mpu9250_H

#include "main.h"
#include "communication_interface.h"

typedef struct Mpu9250Device_T{
	DeviceInterface* interface;
	uint8_t buffer[16];
	uint8_t currentSlave4Address;
} Mpu9250Device;

typedef struct MPU9250_I2CDeviceInterface{
	uint8_t address;
	Mpu9250Device* mpu;
} MPU9250_I2CDeviceInterface;

extern I2C_HandleTypeDef hi2c2;
#define I2C_HANDLE &hi2c2
#define I2C_ADDR 0x68
#define delay(x) HAL_Delay(x)

uint16_t mpu9250_getExternalSensorBytes(Mpu9250Device* mpu, int position, uint8_t* buffer, uint8_t length);
void mpu9250_initDeviceInterface(MPU9250_I2CDeviceInterface* mpu_if, Mpu9250Device* mpu, uint8_t address);
void mpu9250_initMpuDeviceInterface(DeviceInterface* dev_if, MPU9250_I2CDeviceInterface* mpu_if);
uint8_t mpu9250_getAccelDPFL(Mpu9250Device* mpu);
void mpu9250_getAcceleration(Mpu9250Device* mpu, int16_t* x, int16_t* y, int16_t* z);
int16_t mpu9250_getAccelerationX(Mpu9250Device* mpu);
int16_t mpu9250_getAccelerationY(Mpu9250Device* mpu);
int16_t mpu9250_getAccelerationZ(Mpu9250Device* mpu);
uint8_t mpu9250_getAccelerometerPowerOnDelay(Mpu9250Device* mpu);
uint8_t mpu9250_getAccelF_b(Mpu9250Device* mpu);
uint8_t mpu9250_getAccelFIFOEnabled(Mpu9250Device* mpu);
uint8_t mpu9250_getAccelXSelfTest(Mpu9250Device* mpu);
uint8_t mpu9250_getAccelYSelfTest(Mpu9250Device* mpu);
uint8_t mpu9250_getAccelZSelfTest(Mpu9250Device* mpu);
uint8_t mpu9250_getAuxVDDIOLevel(Mpu9250Device* mpu);
uint8_t mpu9250_getClockOutputEnabled(Mpu9250Device* mpu);
uint8_t mpu9250_getClockSource(Mpu9250Device* mpu);
uint8_t mpu9250_getDeviceID(Mpu9250Device* mpu);
uint8_t mpu9250_getDHPFMode(Mpu9250Device* mpu);
uint8_t mpu9250_getDLPFMode(Mpu9250Device* mpu);
uint8_t mpu9250_getDMPConfig1(Mpu9250Device* mpu);
uint8_t mpu9250_getDMPConfig2(Mpu9250Device* mpu);
uint8_t mpu9250_getDMPEnabled(Mpu9250Device* mpu);
uint8_t mpu9250_getDMPInt0Status(Mpu9250Device* mpu);
uint8_t mpu9250_getDMPInt1Status(Mpu9250Device* mpu);
uint8_t mpu9250_getDMPInt2Status(Mpu9250Device* mpu);
uint8_t mpu9250_getDMPInt3Status(Mpu9250Device* mpu);
uint8_t mpu9250_getDMPInt4Status(Mpu9250Device* mpu);
uint8_t mpu9250_getDMPInt5Status(Mpu9250Device* mpu);
uint8_t mpu9250_getExternalFrameSync(Mpu9250Device* mpu);
uint8_t mpu9250_getExternalSensorByte(Mpu9250Device* mpu, int position);
uint32_t mpu9250_getExternalSensorDWord(Mpu9250Device* mpu, int position);
uint16_t mpu9250_getExternalSensorWord(Mpu9250Device* mpu, int position);
uint8_t mpu9250_getExternalShadowDelayEnabled(Mpu9250Device* mpu);
uint8_t mpu9250_getFChoice_b(Mpu9250Device* mpu);
void mpu9250_getFIFOBytes(Mpu9250Device* mpu, uint8_t *data, uint8_t length);
uint8_t mpu9250_getFIFOByte(Mpu9250Device* mpu);
uint16_t mpu9250_getFIFOCount(Mpu9250Device* mpu);
uint8_t mpu9250_getFIFOEnabled(Mpu9250Device* mpu);
uint8_t mpu9250_getFreefallDetectionCounterDecrement(Mpu9250Device* mpu);
uint8_t mpu9250_getFreefallDetectionDuration(Mpu9250Device* mpu);
uint8_t mpu9250_getFreefallDetectionThreshold(Mpu9250Device* mpu);
uint8_t mpu9250_getFSyncInterruptEnabled(Mpu9250Device* mpu);
uint8_t mpu9250_getFSyncInterruptLevel(Mpu9250Device* mpu);
uint8_t mpu9250_getFullScaleAccelRange(Mpu9250Device* mpu);
uint8_t mpu9250_getFullScaleGyroRange(Mpu9250Device* mpu);
uint8_t mpu9250_getI2CBypassEnabled(Mpu9250Device* mpu);
uint8_t mpu9250_getI2CMasterModeEnabled(Mpu9250Device* mpu);
uint8_t mpu9250_getIntDataReadyEnabled(Mpu9250Device* mpu);
uint8_t mpu9250_getIntDataReadyStatus(Mpu9250Device* mpu);
uint8_t mpu9250_getIntDMPEnabled(Mpu9250Device* mpu);
uint8_t mpu9250_getIntDMPStatus(Mpu9250Device* mpu);
uint8_t mpu9250_getIntEnabled(Mpu9250Device* mpu);
uint8_t mpu9250_getInterruptDrive(Mpu9250Device* mpu);
uint8_t mpu9250_getInterruptLatchClear(Mpu9250Device* mpu);
uint8_t mpu9250_getInterruptLatch(Mpu9250Device* mpu);
uint8_t mpu9250_getInterruptMode(Mpu9250Device* mpu);
uint8_t mpu9250_getIntFreefallEnabled(Mpu9250Device* mpu);
uint8_t mpu9250_getIntFreefallStatus(Mpu9250Device* mpu);
uint8_t mpu9250_getIntI2CMasterEnabled(Mpu9250Device* mpu);
uint8_t mpu9250_getIntI2CMasterStatus(Mpu9250Device* mpu);
uint8_t mpu9250_getIntMotionEnabled(Mpu9250Device* mpu);
uint8_t mpu9250_getIntMotionStatus(Mpu9250Device* mpu);
uint8_t mpu9250_getIntPLLReadyEnabled(Mpu9250Device* mpu);
uint8_t mpu9250_getIntPLLReadyStatus(Mpu9250Device* mpu);
uint8_t mpu9250_getIntStatus(Mpu9250Device* mpu);
uint8_t mpu9250_getIntZeroMotionEnabled(Mpu9250Device* mpu);
uint8_t mpu9250_getIntZeroMotionStatus(Mpu9250Device* mpu);
uint8_t mpu9250_getLostArbitration(Mpu9250Device* mpu);
uint8_t mpu9250_getMasterClockSpeed(Mpu9250Device* mpu);
void mpu9250_getMotion6(Mpu9250Device* mpu, int16_t* ax, int16_t* ay, int16_t* az, int16_t* gx, int16_t* gy, int16_t* gz);
void mpu9250_getMotion9(Mpu9250Device* mpu, int16_t* ax, int16_t* ay, int16_t* az, int16_t* gx, int16_t* gy, int16_t* gz, int16_t* mx, int16_t* my, int16_t* mz);
uint8_t mpu9250_getMotionDetectionCounterDecrement(Mpu9250Device* mpu);
uint8_t mpu9250_getMotionDetectionDuration(Mpu9250Device* mpu);
uint8_t mpu9250_getMotionDetectionThreshold(Mpu9250Device* mpu);
uint8_t mpu9250_getMultiMasterEnabled(Mpu9250Device* mpu);
uint8_t mpu9250_getOTPBankValid(Mpu9250Device* mpu);
uint8_t mpu9250_getPassthroughStatus(Mpu9250Device* mpu);
uint8_t mpu9250_getRate(Mpu9250Device* mpu);
void mpu9250_getRotation(Mpu9250Device* mpu, int16_t* x, int16_t* y, int16_t* z);
int16_t mpu9250_getRotationX(Mpu9250Device* mpu);
int16_t mpu9250_getRotationY(Mpu9250Device* mpu);
int16_t mpu9250_getRotationZ(Mpu9250Device* mpu);
uint8_t mpu9250_getSlave4InputByte(Mpu9250Device* mpu);
uint8_t mpu9250_getSlave0FIFOEnabled(Mpu9250Device* mpu);
uint8_t mpu9250_getSlave0Nack(Mpu9250Device* mpu);
uint8_t mpu9250_getSlave1FIFOEnabled(Mpu9250Device* mpu);
uint8_t mpu9250_getSlave1Nack(Mpu9250Device* mpu);
uint8_t mpu9250_getSlave2FIFOEnabled(Mpu9250Device* mpu);
uint8_t mpu9250_getSlave2Nack(Mpu9250Device* mpu);
uint8_t mpu9250_getSlave3FIFOEnabled(Mpu9250Device* mpu);
uint8_t mpu9250_getSlave3Nack(Mpu9250Device* mpu);
uint8_t mpu9250_getSlave4Address(Mpu9250Device* mpu);
uint8_t mpu9250_getSlave4Enabled(Mpu9250Device* mpu);
uint8_t mpu9250_getSlave4InterruptEnabled(Mpu9250Device* mpu);
uint8_t mpu9250_getSlave4IsDone(Mpu9250Device* mpu);
uint8_t mpu9250_getSlave4MasterDelay(Mpu9250Device* mpu);
uint8_t mpu9250_getSlave4Nack(Mpu9250Device* mpu);
uint8_t mpu9250_getSlave4Register(Mpu9250Device* mpu);
uint8_t mpu9250_getSlave4WriteMode(Mpu9250Device* mpu);
uint8_t mpu9250_getSlaveAddress(Mpu9250Device* mpu, uint8_t num);
uint8_t mpu9250_getSlaveDataLength(Mpu9250Device* mpu, uint8_t num);
uint8_t mpu9250_getSlaveDelayEnabled(Mpu9250Device* mpu, uint8_t num);
uint8_t mpu9250_getSlaveEnabled(Mpu9250Device* mpu, uint8_t num);
uint8_t mpu9250_getSlaveReadWriteTransitionEnabled(Mpu9250Device* mpu);
uint8_t mpu9250_getSlaveRegister(Mpu9250Device* mpu, uint8_t num);
uint8_t mpu9250_getSlaveWordByteSwap(Mpu9250Device* mpu, uint8_t num);
uint8_t mpu9250_getSlaveWordGroupOffset(Mpu9250Device* mpu, uint8_t num);
uint8_t mpu9250_getSlaveWriteMode(Mpu9250Device* mpu, uint8_t num);
uint8_t mpu9250_getSleepEnabled(Mpu9250Device* mpu);
uint8_t mpu9250_getStandbyXAccelEnabled(Mpu9250Device* mpu);
uint8_t mpu9250_getStandbyXGyroEnabled(Mpu9250Device* mpu);
uint8_t mpu9250_getStandbyYAccelEnabled(Mpu9250Device* mpu);
uint8_t mpu9250_getStandbyYGyroEnabled(Mpu9250Device* mpu);
uint8_t mpu9250_getStandbyZAccelEnabled(Mpu9250Device* mpu);
uint8_t mpu9250_getStandbyZGyroEnabled(Mpu9250Device* mpu);
int16_t mpu9250_getTemperature(Mpu9250Device* mpu);
uint8_t mpu9250_getTempFIFOEnabled(Mpu9250Device* mpu);
uint8_t mpu9250_getTempSensorEnabled(Mpu9250Device* mpu);
uint8_t mpu9250_getWaitForExternalSensorEnabled(Mpu9250Device* mpu);
uint8_t mpu9250_getWakeCycleEnabled(Mpu9250Device* mpu);
uint8_t mpu9250_getWakeFrequency(Mpu9250Device* mpu);
int16_t mpu9250_getXAccelOffset(Mpu9250Device* mpu);
int8_t mpu9250_getXFineGain(Mpu9250Device* mpu);
uint8_t mpu9250_getXGyroFIFOEnabled(Mpu9250Device* mpu);
int8_t mpu9250_getXGyroOffset(Mpu9250Device* mpu);
int16_t mpu9250_getXGyroOffsetUser(Mpu9250Device* mpu);
uint8_t mpu9250_getXNegMotionDetected(Mpu9250Device* mpu);
uint8_t mpu9250_getXPosMotionDetected(Mpu9250Device* mpu);
int16_t mpu9250_getYAccelOffset(Mpu9250Device* mpu);
int8_t mpu9250_getYFineGain(Mpu9250Device* mpu);
uint8_t mpu9250_getYGyroFIFOEnabled(Mpu9250Device* mpu);
int8_t mpu9250_getYGyroOffset(Mpu9250Device* mpu);
int16_t mpu9250_getYGyroOffsetUser(Mpu9250Device* mpu);
uint8_t mpu9250_getYNegMotionDetected(Mpu9250Device* mpu);
uint8_t mpu9250_getYPosMotionDetected(Mpu9250Device* mpu);
int16_t mpu9250_getZAccelOffset(Mpu9250Device* mpu);
uint8_t mpu9250_getZeroMotionDetected(Mpu9250Device* mpu);
uint8_t mpu9250_getZeroMotionDetectionDuration(Mpu9250Device* mpu);
uint8_t mpu9250_getZeroMotionDetectionThreshold(Mpu9250Device* mpu);
int8_t mpu9250_getZFineGain(Mpu9250Device* mpu);
uint8_t mpu9250_getZGyroFIFOEnabled(Mpu9250Device* mpu);
int8_t mpu9250_getZGyroOffset(Mpu9250Device* mpu);
int16_t mpu9250_getZGyroOffsetUser(Mpu9250Device* mpu);
uint8_t mpu9250_getZNegMotionDetected(Mpu9250Device* mpu);
uint8_t mpu9250_getZPosMotionDetected(Mpu9250Device* mpu);
void mpu9250_initialize(Mpu9250Device* mpu);
void mpu9250_readMemoryBlock(Mpu9250Device* mpu, uint8_t *data, uint16_t dataSize, uint8_t bank, uint8_t address);
uint8_t mpu9250_readMemoryByte(Mpu9250Device* mpu);
void mpu9250_resetAccelerometerPath(Mpu9250Device* mpu);
void mpu9250_resetDMP(Mpu9250Device* mpu);
void mpu9250_resetFIFO(Mpu9250Device* mpu);
void mpu9250_resetGyroscopePath(Mpu9250Device* mpu);
void mpu9250_resetI2CMaster(Mpu9250Device* mpu);
void mpu9250_resetSensors(Mpu9250Device* mpu);
void mpu9250_resetTemperaturePath(Mpu9250Device* mpu);
void mpu9250_reset(Mpu9250Device* mpu);
void mpu9250_setAccelDPFL(Mpu9250Device* mpu, uint8_t mode);
void mpu9250_setAccelerometerPowerOnDelay(Mpu9250Device* mpu, uint8_t delay);
void mpu9250_setAccelF_b(Mpu9250Device* mpu, uint8_t b);
void mpu9250_setAccelFIFOEnabled(Mpu9250Device* mpu, uint8_t enabled);
void mpu9250_setAccelXSelfTest(Mpu9250Device* mpu, uint8_t enabled);
void mpu9250_setAccelYSelfTest(Mpu9250Device* mpu, uint8_t enabled);
void mpu9250_setAccelZSelfTest(Mpu9250Device* mpu, uint8_t enabled);
void mpu9250_setAuxVDDIOLevel(Mpu9250Device* mpu, uint8_t level);
void mpu9250_setClockOutputEnabled(Mpu9250Device* mpu, uint8_t enabled);
void mpu9250_setClockSource(Mpu9250Device* mpu, uint8_t source);
void mpu9250_setDeviceID(Mpu9250Device* mpu, uint8_t id);
void mpu9250_setDHPFMode(Mpu9250Device* mpu, uint8_t bandwidth);
void mpu9250_setDLPFMode(Mpu9250Device* mpu, uint8_t mode);
void mpu9250_setDMPConfig1(Mpu9250Device* mpu, uint8_t config);
void mpu9250_setDMPConfig2(Mpu9250Device* mpu, uint8_t config);
void mpu9250_setDMPEnabled(Mpu9250Device* mpu, uint8_t enabled);
void mpu9250_setExternalFrameSync(Mpu9250Device* mpu, uint8_t sync);
void mpu9250_setExternalShadowDelayEnabled(Mpu9250Device* mpu, uint8_t enabled);
void mpu9250_setFChoice_b(Mpu9250Device* mpu, uint8_t b);
void mpu9250_setFIFOByte(Mpu9250Device* mpu, uint8_t data);
void mpu9250_setFIFOEnabled(Mpu9250Device* mpu, uint8_t enabled);
void mpu9250_setFreefallDetectionCounterDecrement(Mpu9250Device* mpu, uint8_t decrement);
void mpu9250_setFreefallDetectionDuration(Mpu9250Device* mpu, uint8_t duration);
void mpu9250_setFreefallDetectionThreshold(Mpu9250Device* mpu, uint8_t threshold);
void mpu9250_setFSyncInterruptEnabled(Mpu9250Device* mpu, uint8_t enabled);
void mpu9250_setFSyncInterruptLevel(Mpu9250Device* mpu, uint8_t level);
void mpu9250_setFullScaleAccelRange(Mpu9250Device* mpu, uint8_t range);
void mpu9250_setFullScaleGyroRange(Mpu9250Device* mpu, uint8_t range);
void mpu9250_setI2CBypassEnabled(Mpu9250Device* mpu, uint8_t enabled);
void mpu9250_setI2CMasterModeEnabled(Mpu9250Device* mpu, uint8_t enabled);
void mpu9250_setIntDataReadyEnabled(Mpu9250Device* mpu, uint8_t enabled);
void mpu9250_setIntDMPEnabled(Mpu9250Device* mpu, uint8_t enabled);
void mpu9250_setIntEnabled(Mpu9250Device* mpu, uint8_t enabled);
void mpu9250_setInterruptDrive(Mpu9250Device* mpu, uint8_t drive);
void mpu9250_setInterruptLatchClear(Mpu9250Device* mpu, uint8_t clear);
void mpu9250_setInterruptLatch(Mpu9250Device* mpu, uint8_t latch);
void mpu9250_setInterruptMode(Mpu9250Device* mpu, uint8_t mode);
void mpu9250_setIntFreefallEnabled(Mpu9250Device* mpu, uint8_t enabled);
void mpu9250_setIntI2CMasterEnabled(Mpu9250Device* mpu, uint8_t enabled);
void mpu9250_setIntMotionEnabled(Mpu9250Device* mpu, uint8_t enabled);
void mpu9250_setIntPLLReadyEnabled(Mpu9250Device* mpu, uint8_t enabled);
void mpu9250_setIntZeroMotionEnabled(Mpu9250Device* mpu, uint8_t enabled);
void mpu9250_setMasterClockSpeed(Mpu9250Device* mpu, uint8_t speed);
void mpu9250_setMemoryBank(Mpu9250Device* mpu, uint8_t bank);
void mpu9250_setMemoryStartAddress(Mpu9250Device* mpu, uint8_t address);
void mpu9250_setMotionDetectionCounterDecrement(Mpu9250Device* mpu, uint8_t decrement);
void mpu9250_setMotionDetectionDuration(Mpu9250Device* mpu, uint8_t duration);
void mpu9250_setMotionDetectionThreshold(Mpu9250Device* mpu, uint8_t threshold);
void mpu9250_setMultiMasterEnabled(Mpu9250Device* mpu, uint8_t enabled);
void mpu9250_setOTPBankValid(Mpu9250Device* mpu, uint8_t enabled);
void mpu9250_setRate(Mpu9250Device* mpu, uint8_t rate);
void mpu9250_setSlave0FIFOEnabled(Mpu9250Device* mpu, uint8_t enabled);
void mpu9250_setSlave1FIFOEnabled(Mpu9250Device* mpu, uint8_t enabled);
void mpu9250_setSlave2FIFOEnabled(Mpu9250Device* mpu, uint8_t enabled);
void mpu9250_setSlave3FIFOEnabled(Mpu9250Device* mpu, uint8_t enabled);
void mpu9250_setSlave4Address(Mpu9250Device* mpu, uint8_t address);
void mpu9250_setSlave4Enabled(Mpu9250Device* mpu, uint8_t enabled);
void mpu9250_setSlave4InterruptEnabled(Mpu9250Device* mpu, uint8_t enabled);
void mpu9250_setSlave4MasterDelay(Mpu9250Device* mpu, uint8_t delay);
void mpu9250_setSlave4OutputByte(Mpu9250Device* mpu, uint8_t data);
void mpu9250_setSlave4Register(Mpu9250Device* mpu, uint8_t reg);
void mpu9250_setSlave4WriteMode(Mpu9250Device* mpu, uint8_t mode);
void mpu9250_setSlaveAddress(Mpu9250Device* mpu, uint8_t num, uint8_t address);
void mpu9250_setSlaveDataLength(Mpu9250Device* mpu, uint8_t num, uint8_t length);
void mpu9250_setSlaveDelayEnabled(Mpu9250Device* mpu, uint8_t num, uint8_t enabled);
void mpu9250_setSlaveEnabled(Mpu9250Device* mpu, uint8_t num, uint8_t enabled);
void mpu9250_setSlaveOutputByte(Mpu9250Device* mpu, uint8_t num, uint8_t data);
void mpu9250_setSlaveReadWriteTransitionEnabled(Mpu9250Device* mpu, uint8_t enabled);
void mpu9250_setSlaveRegister(Mpu9250Device* mpu, uint8_t num, uint8_t reg);
void mpu9250_setSlaveWordByteSwap(Mpu9250Device* mpu, uint8_t num, uint8_t enabled);
void mpu9250_setSlaveWordGroupOffset(Mpu9250Device* mpu, uint8_t num, uint8_t enabled);
void mpu9250_setSlaveWriteMode(Mpu9250Device* mpu, uint8_t num, uint8_t mode);
void mpu9250_setSleepEnabled(Mpu9250Device* mpu, uint8_t enabled);
void mpu9250_setStandbyXAccelEnabled(Mpu9250Device* mpu, uint8_t enabled);
void mpu9250_setStandbyXGyroEnabled(Mpu9250Device* mpu, uint8_t enabled);
void mpu9250_setStandbyYAccelEnabled(Mpu9250Device* mpu, uint8_t enabled);
void mpu9250_setStandbyYGyroEnabled(Mpu9250Device* mpu, uint8_t enabled);
void mpu9250_setStandbyZAccelEnabled(Mpu9250Device* mpu, uint8_t enabled);
void mpu9250_setStandbyZGyroEnabled(Mpu9250Device* mpu, uint8_t enabled);
void mpu9250_setTempFIFOEnabled(Mpu9250Device* mpu, uint8_t enabled);
void mpu9250_setTempSensorEnabled(Mpu9250Device* mpu, uint8_t enabled);
void mpu9250_setWaitForExternalSensorEnabled(Mpu9250Device* mpu, uint8_t enabled);
void mpu9250_setWakeCycleEnabled(Mpu9250Device* mpu, uint8_t enabled);
void mpu9250_setWakeFrequency(Mpu9250Device* mpu, uint8_t frequency);
void mpu9250_setXAccelOffset(Mpu9250Device* mpu, int16_t offset);
void mpu9250_setXFineGain(Mpu9250Device* mpu, int8_t gain);
void mpu9250_setXGyroFIFOEnabled(Mpu9250Device* mpu, uint8_t enabled);
void mpu9250_setXGyroOffsetUser(Mpu9250Device* mpu, int16_t offset);
void mpu9250_setXGyroOffset(Mpu9250Device* mpu, int8_t offset);
void mpu9250_setYAccelOffset(Mpu9250Device* mpu, int16_t offset);
void mpu9250_setYFineGain(Mpu9250Device* mpu, int8_t gain);
void mpu9250_setYGyroFIFOEnabled(Mpu9250Device* mpu, uint8_t enabled);
void mpu9250_setYGyroOffsetUser(Mpu9250Device* mpu, int16_t offset);
void mpu9250_setYGyroOffset(Mpu9250Device* mpu, int8_t offset);
void mpu9250_setZAccelOffset(Mpu9250Device* mpu, int16_t offset);
void mpu9250_setZeroMotionDetectionDuration(Mpu9250Device* mpu, uint8_t duration);
void mpu9250_setZeroMotionDetectionThreshold(Mpu9250Device* mpu, uint8_t threshold);
void mpu9250_setZFineGain(Mpu9250Device* mpu, int8_t gain);
void mpu9250_setZGyroFIFOEnabled(Mpu9250Device* mpu, uint8_t enabled);
void mpu9250_setZGyroOffsetUser(Mpu9250Device* mpu, int16_t offset);
void mpu9250_setZGyroOffset(Mpu9250Device* mpu, int8_t offset);
void mpu9250_switchSPIEnabled(Mpu9250Device* mpu, uint8_t enabled);
uint8_t mpu9250_testConnection(Mpu9250Device* mpu);
uint8_t mpu9250_writeDMPConfigurationSet(Mpu9250Device* mpu, const uint8_t *data, uint16_t dataSize, uint8_t useProgMem);
uint8_t mpu9250_writeMemoryBlock(Mpu9250Device* mpu, const uint8_t *data, uint16_t dataSize, uint8_t bank, uint8_t address, uint8_t verify, uint8_t useProgMem);
void mpu9250_writeMemoryByte(Mpu9250Device* mpu, uint8_t data);
uint8_t mpu9250_writeProgDMPConfigurationSet(Mpu9250Device* mpu, const uint8_t *data, uint16_t dataSize);
uint8_t mpu9250_writeProgMemoryBlock(Mpu9250Device* mpu, const uint8_t *data, uint16_t dataSize, uint8_t bank, uint8_t address, uint8_t verify);
#endif
