SukuWc/FR4-Quad/Firmware/quad_revb/Inc/bsp/devices.h

/*
 * devices.h
 *
 *  Created on: 2019. ápr. 5.
 *      Author: danim
 */

#ifndef BSP_DEVICES_H_
#define BSP_DEVICES_H_

#include "mpu9250.h"
#include "mpu9250_regs.h"

extern Mpu9250Device mpu_device;

#endif /* BSP_DEVICES_H_ */
