SukuWc/FR4-Quad/Firmware/nrf24_test/Src/main.c

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

/* Includes ------------------------------------------------------------------*/
#include "main.h"
#include "spi.h"
#include "gpio.h"

/* USER CODE BEGIN Includes */
#include "nrf24.h"
/* USER CODE END Includes */


/* USER CODE BEGIN PV */
uint8_t receiver = 1;
/* USER CODE END PV */

void SystemClock_Config(void);
/**
  * @brief  The application entry point.
  * @retval int
  */
int main(void)
{
  /* MCU Configuration--------------------------------------------------------*/

  /* Reset of all peripherals, Initializes the Flash interface and the Systick. */
  HAL_Init();

  /* Configure the system clock */
  SystemClock_Config();

  /* Initialize all configured peripherals */
  MX_GPIO_Init();
  MX_SPI1_Init();
  /* USER CODE BEGIN 2 */
  HAL_Delay(10);

  nRF24_Init();
  uint8_t ADDR[] = { 'n', 'R', 'F', '2', '4' }; // the address for RX pipe
  nRF24_DisableAA(0xFF); // disable ShockBurst
  nRF24_SetRFChannel(115); // set RF channel to 2490MHz
  nRF24_SetDataRate(nRF24_DR_250kbps); // 2Mbit/s data rate
  nRF24_SetCRCScheme(nRF24_CRC_off); // 1-byte CRC scheme
  nRF24_SetAddrWidth(5); // address width is 5 bytes
  if (receiver){
    nRF24_SetAddr(nRF24_PIPE1, ADDR); // program pipe address
    nRF24_SetRXPipe(nRF24_PIPE1, nRF24_AA_OFF, 14); // enable RX pipe#1 with Auto-ACK: disabled, payload length: 10 bytes
    nRF24_SetOperationalMode(nRF24_MODE_RX); // switch transceiver to the RX mode
    // then pull CE pin to HIGH, and the nRF24 will start a receive...
  } else {
    nRF24_SetTXPower(nRF24_TXPWR_18dBm); // configure TX power
    nRF24_SetAddr(nRF24_PIPETX, ADDR); // program TX address
    nRF24_SetOperationalMode(nRF24_MODE_TX); // switch transceiver to the TX mode
    nRF24_ClearIRQFlags(); // clear any pending IRQ bits
    // the nRF24 is ready for transmission, upload a payload, then pull CE pin to HIGH and it will transmit a packet...
  }
  nRF24_SetPowerMode(nRF24_PWR_UP); // wake-up transceiver (in case if it sleeping)

  volatile uint8_t nrf24_status = nRF24_Check();
  /* USER CODE END 2 */

  /* Infinite loop */
  /* USER CODE BEGIN WHILE */
  volatile uint8_t status;
  volatile uint8_t ret;
  volatile uint8_t cnt = 0;
  while (1)
  {
    /* USER CODE END WHILE */
    if (receiver){
      uint8_t nRF24_payload[32] = {0}; // buffer for payload
      uint8_t payload_length; // variable to store a length of received payload
      uint8_t pipe; // pipe number
      nRF24_CE_H(); // start receiving
      while (1) {
          // constantly poll the status of RX FIFO...
          if (nRF24_GetStatus_RXFIFO() != nRF24_STATUS_RXFIFO_EMPTY) {
              // the RX FIFO have some data, take a note what nRF24 can hold up to three payloads of 32 bytes...
              pipe = nRF24_ReadPayload(nRF24_payload, &payload_length); // read a payload to buffer
              nRF24_ClearIRQFlags(); // clear any pending IRQ bits
              // now the nRF24_payload buffer holds received data
              // payload_length variable holds a length of received data
              // pipe variable holds a number of the pipe which has received the data
              // ... do something with received data ...
              cnt++;
          }
      }
    } else {
      uint8_t payload[] = "Hello World! \n";
      payload[12] = cnt++;
      nRF24_CE_L();
      nRF24_WritePayload(payload, 14); // transfer payload data to transceiver
      nRF24_CE_H(); // assert CE pin (transmission starts)
      while (1) {
          status = nRF24_GetStatus();
          if (status & (nRF24_FLAG_TX_DS | nRF24_FLAG_MAX_RT)) {
              // transmission ended, exit loop
              break;
          }
      }
      nRF24_CE_L(); // de-assert CE pin (nRF24 goes to StandBy-I mode)
      nRF24_ClearIRQFlags(); // clear any pending IRQ flags
      nRF24_FlushTX();
      if (status & nRF24_FLAG_MAX_RT) {
          // Auto retransmit counter exceeds the programmed maximum limit (payload in FIFO is not removed)
          // Also the software can flush the TX FIFO here...
          ret = -1;
          continue;
      }
      if (status & nRF24_FLAG_TX_DS) {
          // Successful transmission
          ret = 0;
          continue;
      }
      nRF24_FlushTX();
      // In fact that should not happen
      ret = -2;
    }
    /* USER CODE BEGIN 3 */
  }
  /* USER CODE END 3 */
}

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
