SukuWc/FR4-Quad/Firmware/nrf24_test/Inc/nrf24_hal.h

#ifndef __NRF24_HAL_H
#define __NRF24_HAL_H


// Hardware abstraction layer for NRF24L01+ transceiver (hardware depended functions)
// GPIO pins definition
// GPIO pins initialization and control functions
// SPI transmit functions


// Peripheral libraries
#include <gpio.h>
#include <spi.h>


// SPI port peripheral
#define nRF24_SPI_HANDLE           &hspi1

// nRF24 GPIO peripherals
#define nRF24_GPIO_PERIPHERALS     (RCC_APB2ENR_IOPBEN)

// CE (chip enable) pin (PB11)
#define nRF24_CE_PORT              GPIOB
#define nRF24_CE_PIN               GPIO_PIN_13
#define nRF24_CE_L()               HAL_GPIO_WritePin(nRF24_CE_PORT, nRF24_CE_PIN, GPIO_PIN_RESET)
#define nRF24_CE_H()               HAL_GPIO_WritePin(nRF24_CE_PORT, nRF24_CE_PIN, GPIO_PIN_SET)

// CSN (chip select negative) pin (PB12)
#define nRF24_CSN_PORT             GPIOB
#define nRF24_CSN_PIN              GPIO_PIN_14
#define nRF24_CSN_L()              HAL_GPIO_WritePin(nRF24_CSN_PORT, nRF24_CSN_PIN, GPIO_PIN_RESET)
#define nRF24_CSN_H()              HAL_GPIO_WritePin(nRF24_CSN_PORT, nRF24_CSN_PIN, GPIO_PIN_SET)

// IRQ pin (PB10)
#define nRF24_IRQ_PORT             GPIOB
#define nRF24_IRQ_PIN              GPIO_Pin_15


// Function prototypes
void nRF24_GPIO_Init(void);
uint8_t nRF24_LL_RW(uint8_t data);

#endif // __NRF24_HAL_H
