SukuWc/FR4-Quad/(commit log)

2018-06-05 SUKU FR4 Quad INIT
    [9032_Joystick.STEP, FR4.0002.ipt, FR4.ipt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]
2018-06-05 SUKU FR4 Radio
    [FR4Radio.pdsprj]
2018-06-05 SUKU FW
    [FR4Quad.pdsprj]
2018-06-05 CubeMX file update + test project added
    [test Debug.cfg]
2018-07-17 SUKU Quad REVA nsent out to manufacturer + backup
    [FR4Quad - CADCAM Bottom Assembly.GBR, FR4Quad - CADCAM Bottom Copper.GBR, FR4Quad - CADCAM Bottom SMT Paste.GBR, FR4Quad - CADCAM Bottom Silk Screen.GBR, FR4Quad - CADCAM Bottom Solder Resist.GBR, FR4Quad - CADCAM Drill.DRL, FR4Quad - CADCAM Mechanical 3.GBR, FR4Quad - CADCAM Top Assembly.GBR]
2018-08-09 SUKU RevA backup RevB init
    [FR4Quad.pdsprj, FR4_Brain.pdsprj, FR4_Frame_Basic.pdsprj]
2019-01-28 SUKU Render: BOM, Sch, PCB
    [Bill Of Materials FR4Quad.csv]
2019-02-11 Start project
    [New_configuration.cfg, test Debug.cfg]
2019-02-11 Sensor readings added
    [QuadFW_F103 Debug.cfg]
2019-02-25 SUKU FR4Quad project file updated
    [FR4Quad.pdsprj]
2019-02-25 Simulation started, radio test added
    [New_configuration.cfg, nrf24_test Debug.cfg, params.txt]
2019-02-26 SUKU Arduino-Micro-PPM-Test added
2019-02-26 Test drive
    [QuadFW_F103 Debug.cfg]
2019-03-02 SUKU 3D printable legs added
    [leg.FCStd, leg.stl]
2019-03-02 UART in progress
2019-03-09 Added complementer filter
2019-03-13 SUKU SensorMix PCB layout done.
    [FR4_SensorMix.pdsprj]
2019-03-14 Instabil flying
    [putty.csv]
2019-03-18 Added PID
2019-03-18 SUKU RevB PCB layout DONE RENDER ORDER
    [FR4_Bluetooth_HC-05.pdsprj, FR4_Brain.STEP, FR4_Brain.pdsprj, FR4_Frame_Basic.pdsprj, FR4_Proto.pdsprj, FR4_SensorMix.STEP, FR4_SensorMix.pdsprj]
2019-03-18 PID controller added
2019-03-18 Add gyro offsets
2019-03-19 Kalman filter added
2019-03-19 Kalman filter tuning
2019-03-28 Added device interface structure
    [New_configuration.cfg, QuadFW_F103 Debug.cfg]
2019-04-05 Switch to revb
2019-04-30 Device interface update
2019-05-03 Fix compile errors for real code
    [devices.c, main.c, system_core.c]
2019-05-04 Added MPU device interface, sensor configuring through MPU, and automatic sensor reading
2019-05-12 Good sensors
2019-05-18 SUKU All Output files added for RevB components
    [Bill Of Materials FR4Quad.csv, Brain_BOM.csv, FR4_Brain.STEP, FR4_Brain.pdsprj, FR4_Frame_Basic.STEP, FR4_Frame_Basic.pdsprj, FR4_SensorMix.STEP, FR4_SensorMix.pdsprj]
