SukuWc/FR4-Quad/(notices)

Notices in the files:
Firmware/nrf24_test/Src/main.c:
COPYRIGHT(c) 2019 STMicroelectronics
(C) COPYRIGHT STMicroelectronics *****END OF FILE
